pong74ls/ComputerSpaceDesign/PCB Pictures/Sync Star Board - Solder Side.JPG

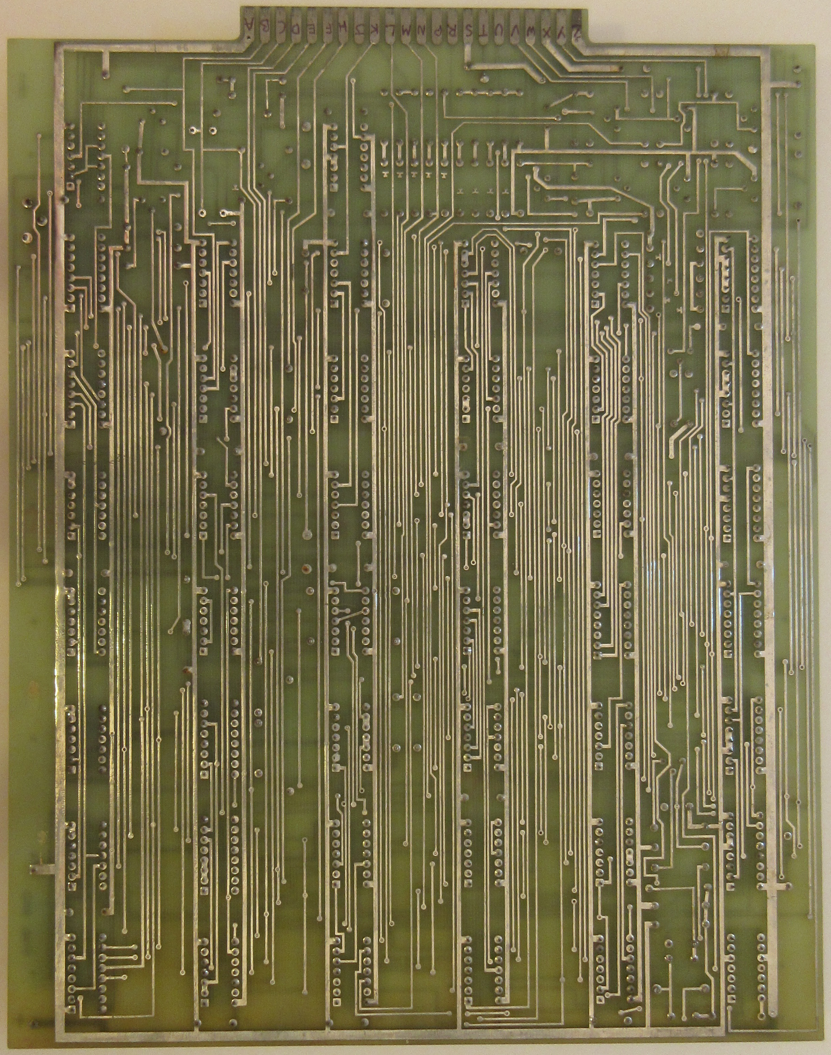
PCB Pictures/Sync Star Board - Solder Side.JPG
