pong74ls/ComputerSpaceDesign/Gerber/Computer Space - Memory Board - CADCAM Mechanical 1.TXT

G04 PROTEUS RS274X GERBER FILE*
%FSLAX24Y24*%
%MOIN*%
%ADD23C,0.0010*%
%ADD17C,0.0100*%
G54D23*
X+3750Y+0D02*
X+103750Y+0D01*
X+103750Y+81250D01*
X+3750Y+81250D01*
X+3750Y+60300D01*
X+0Y+60300D01*
X+0Y+25500D01*
X+3750Y+25500D01*
X+3750Y+0D01*
G54D17*
X+150Y+60300D02*
X+150Y+25500D01*
M00*
