pong74ls/ComputerSpaceDesign/Gerber/Computer Space - Motion Board - CADCAM Mechanical 1.TXT

G04 PROTEUS RS274X GERBER FILE*
%FSLAX24Y24*%
%MOIN*%
%ADD24C,0.0010*%
G54D24*
X+0Y+0D02*
X+100000Y+0D01*
X+100000Y+16750D01*
X+103750Y+16750D01*
X+103750Y+51500D01*
X+100000Y+51500D01*
X+100000Y+80500D01*
X+0Y+80500D01*
X+0Y+0D01*
M00*
