pong74ls/ComputerSpaceDesign/Gerber/Computer Space - Sync Star Board Model 1 - CADCAM Mechanical 1.TXT

G04 PROTEUS RS274X GERBER FILE*
%FSLAX24Y24*%
%MOIN*%
%ADD25C,0.0010*%
%ADD29C,0.0060*%
G54D25*
X+103400Y+23000D02*
X+99750Y+23000D01*
X+99750Y+0D01*
X+0Y+0D01*
X+0Y+80750D01*
X+99750Y+80750D01*
X+99750Y+57750D01*
X+103400Y+57750D01*
X+103400Y+23000D01*
G54D29*
X+103300Y+57750D02*
X+103300Y+23000D01*
M00*
