pong74ls/ComputerSpaceDesign/Datasheets/GE Television Modifications.jpg

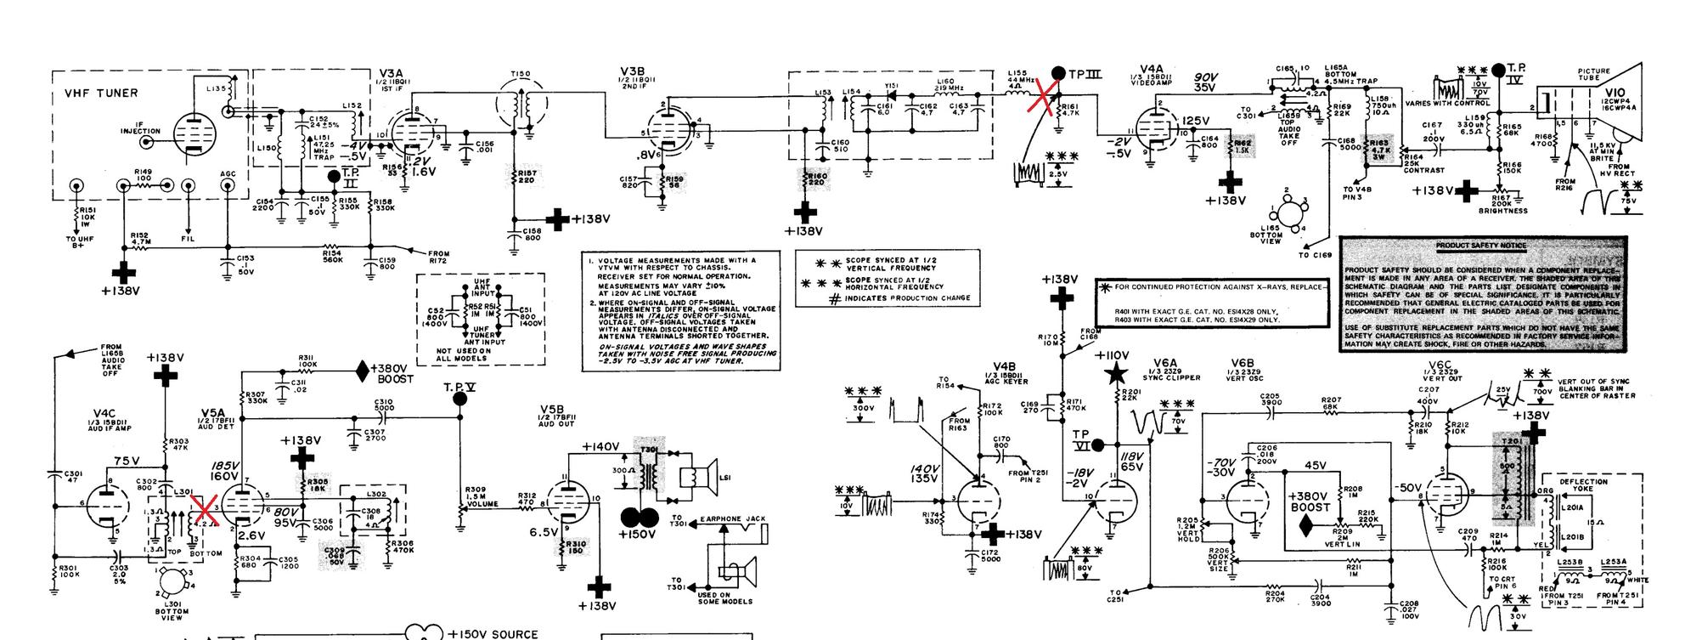
Datasheets/GE Television Modifications.jpg
