pong74ls/ComputerSpaceDesign/Datasheets/TO-105 transistor case pinout.png

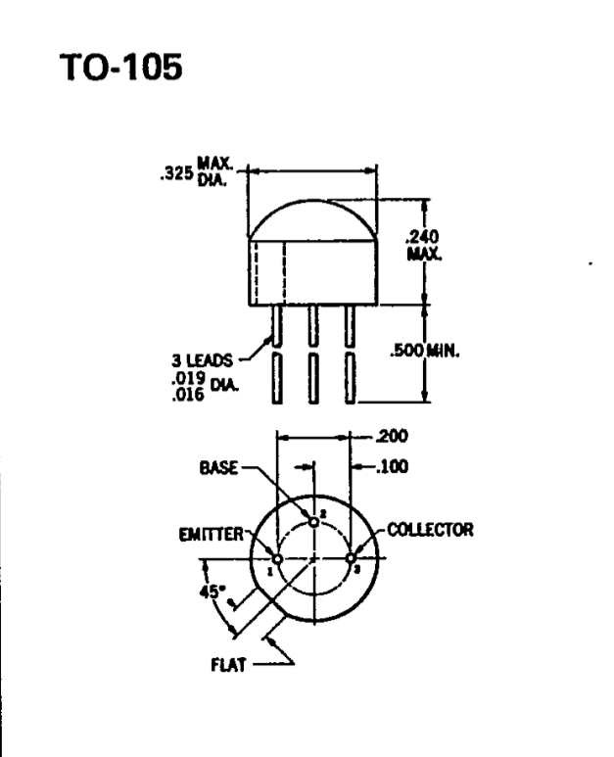
Datasheets/TO-105 transistor case pinout.png
