pong74ls/ComputerSpaceDesign/PCB Pictures/Sync Star Board - Video Mixer Detail.JPG

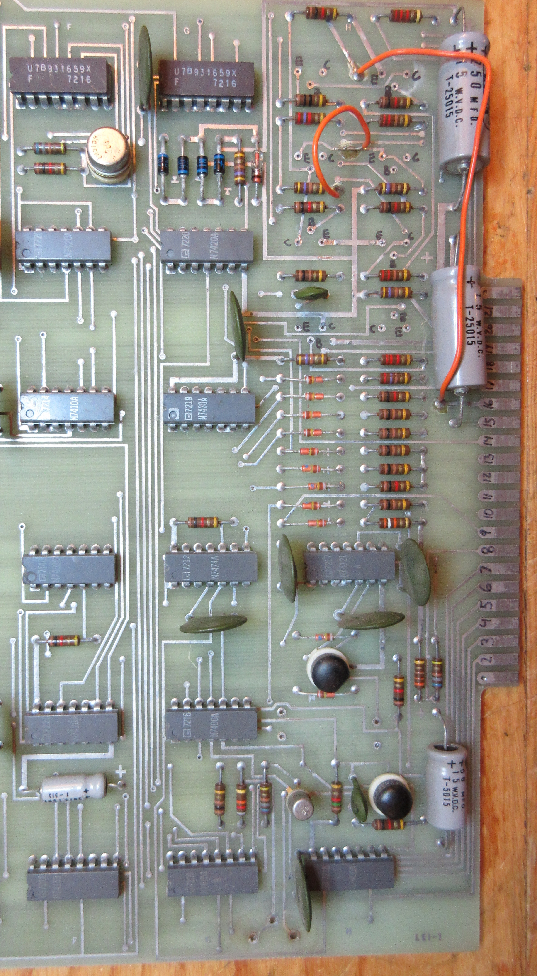
PCB Pictures/Sync Star Board - Video Mixer Detail.JPG
