pong74ls/ComputerSpaceDesign/PCB Scan/Memory Board Bottom B&W.bmp

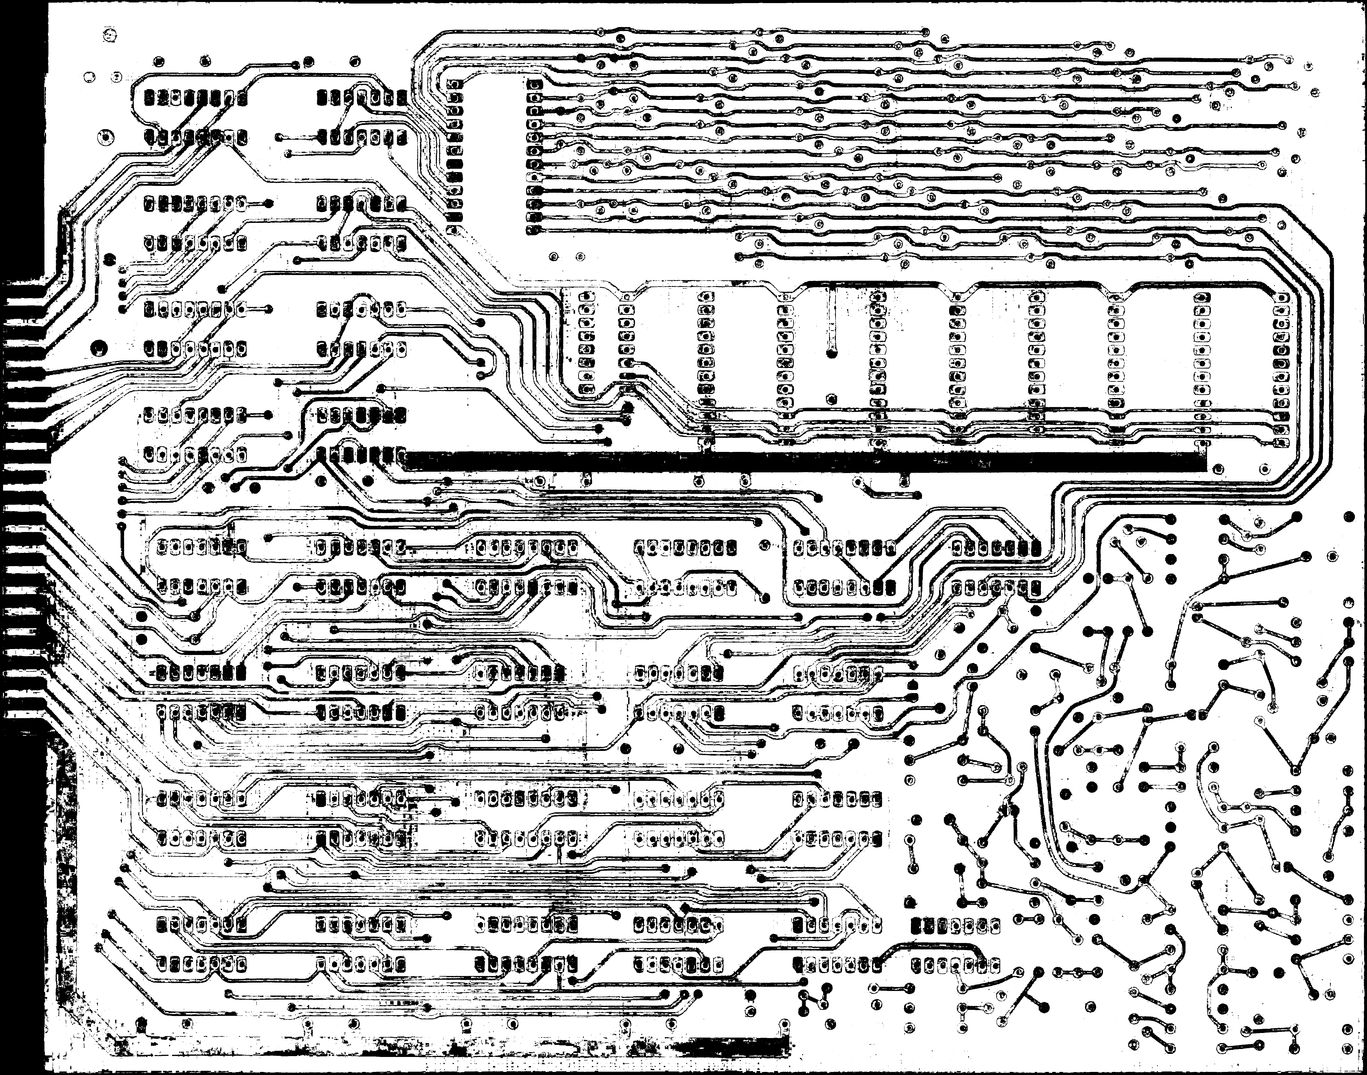
PCB Scan/Memory Board Bottom B&W.bmp
