pong74ls/ComputerSpaceDesign/PCB Scan/Memory Board Top B&W.bmp

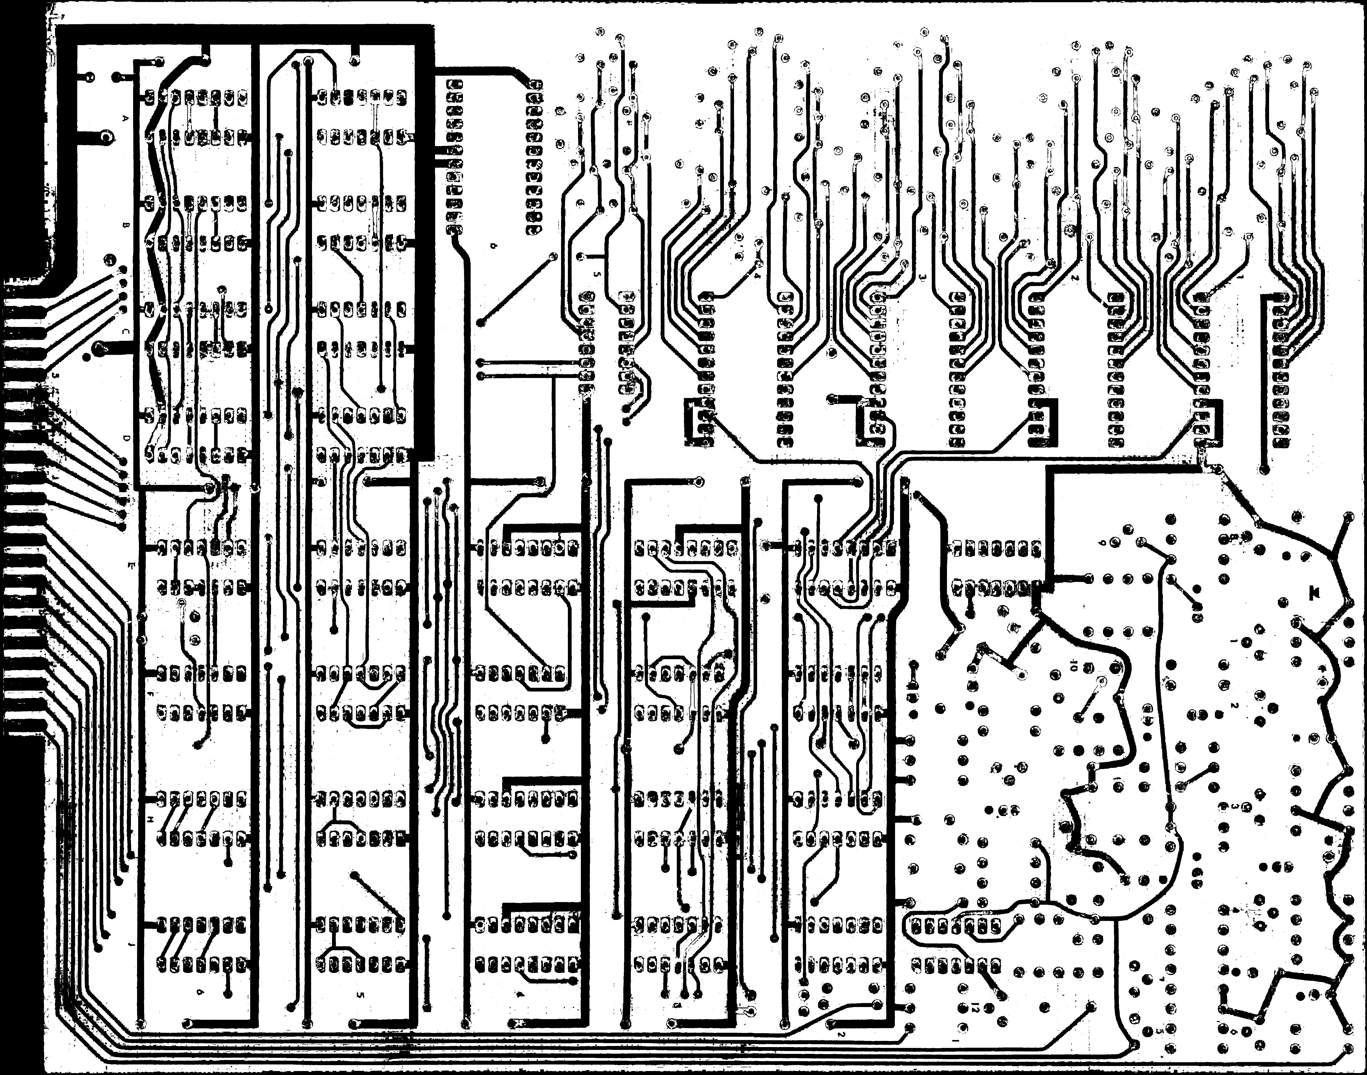
PCB Scan/Memory Board Top B&W.bmp
