pong74ls/ComputerSpaceDesign/PCB Scan/Motion Board Bottom B&W.bmp

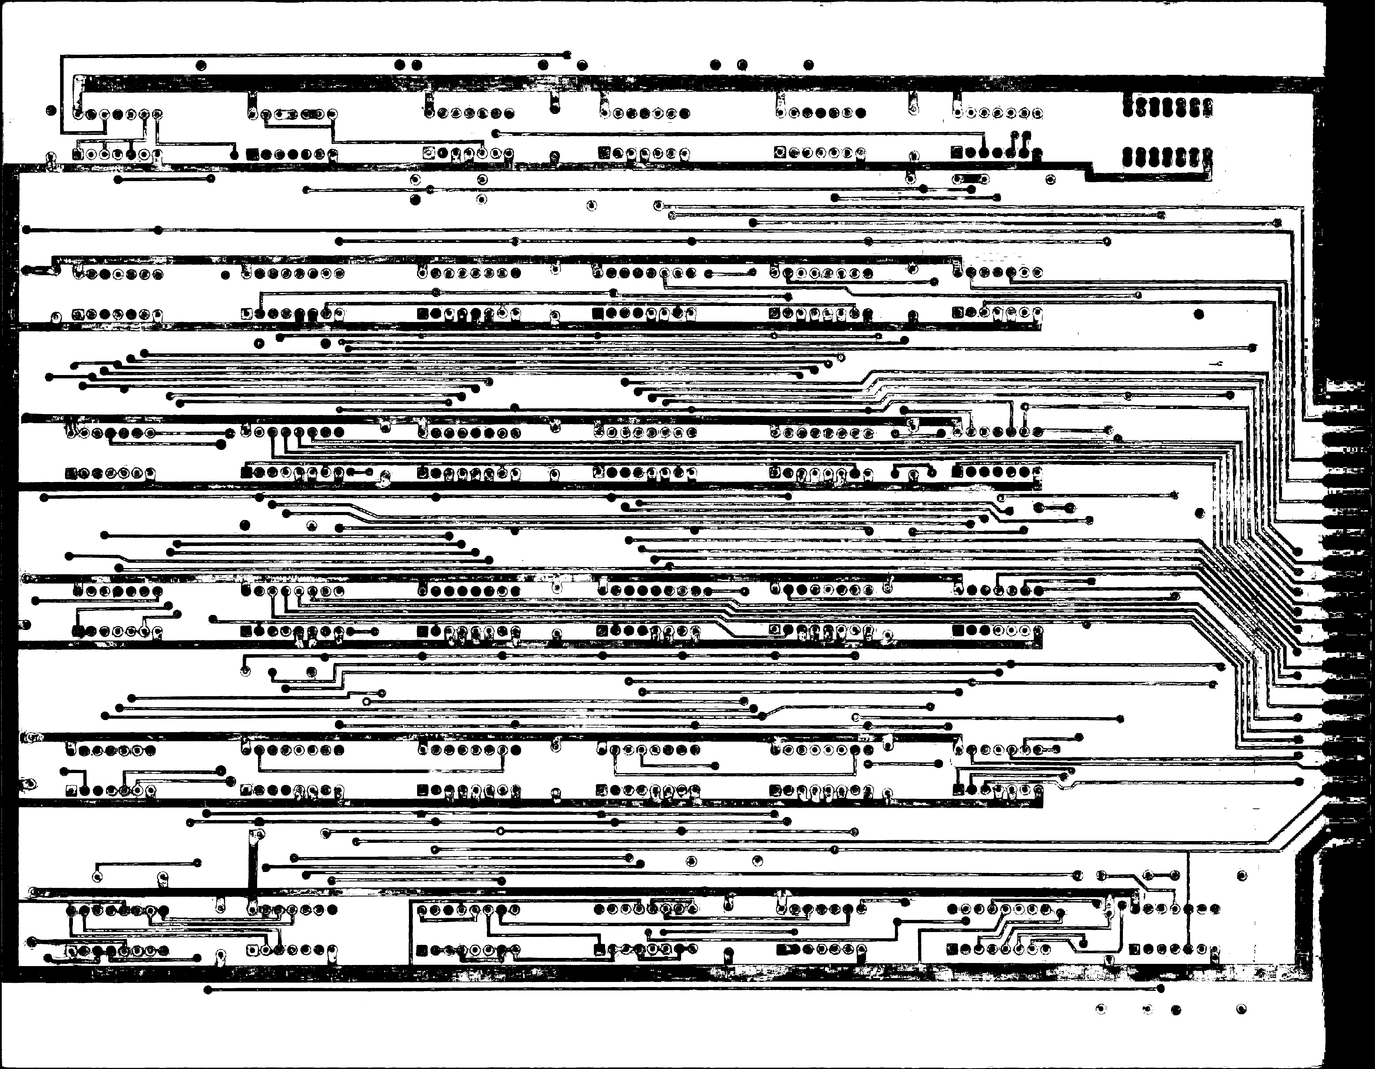
PCB Scan/Motion Board Bottom B&W.bmp
