pong74ls/ComputerSpaceDesign/PCB Scan/Motion Board Top B&W.bmp

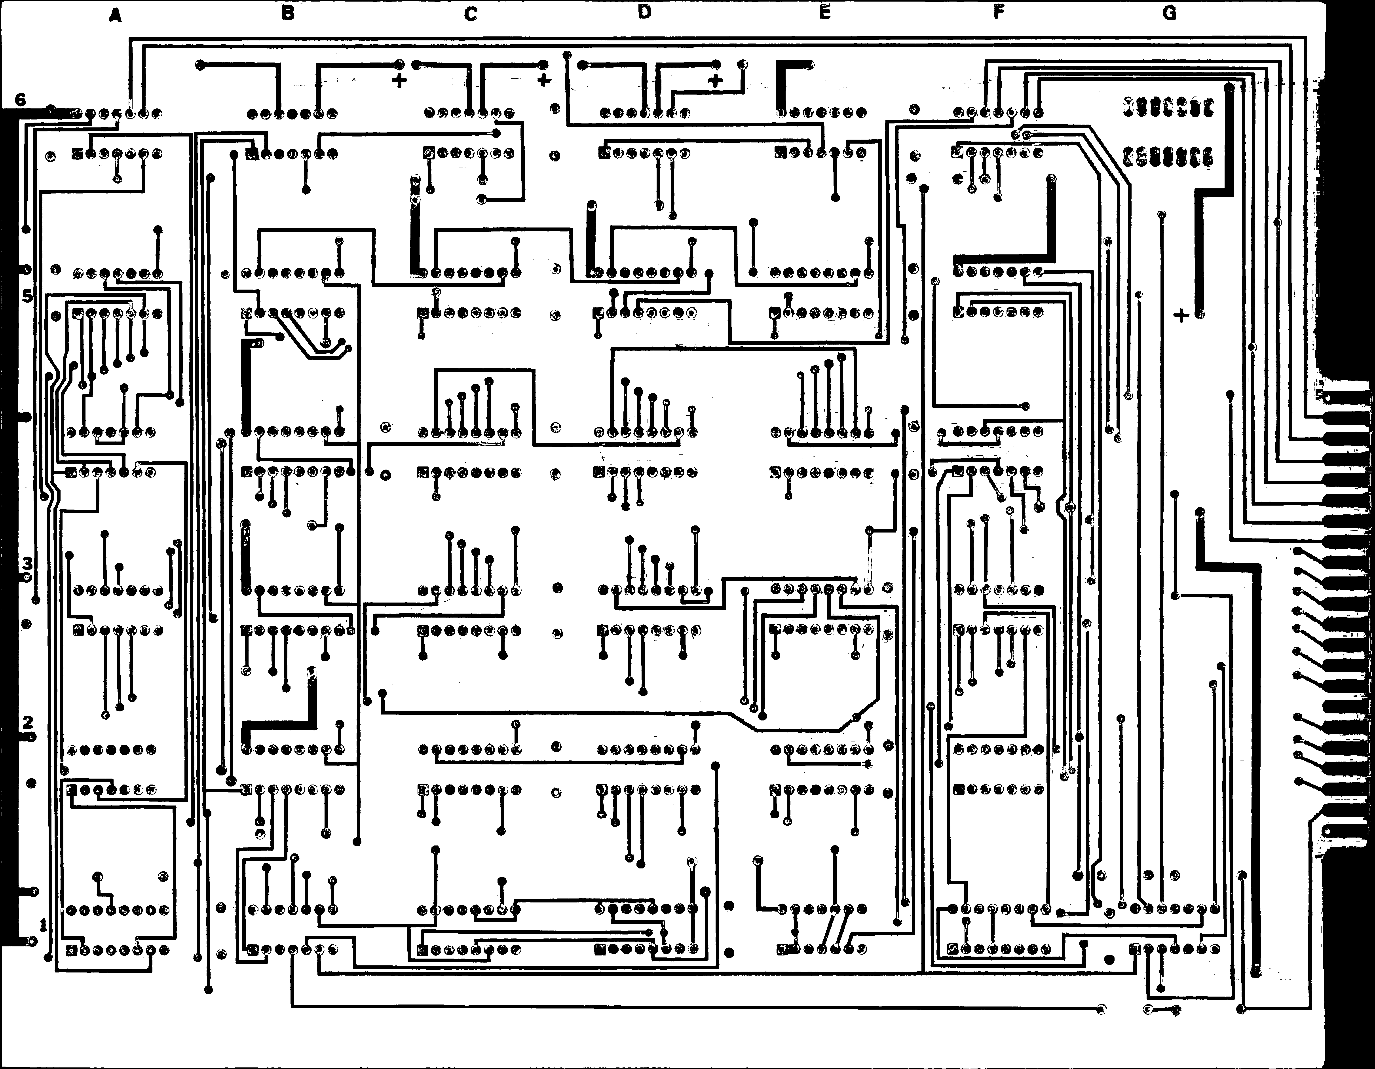
PCB Scan/Motion Board Top B&W.bmp
