pong74ls/ComputerSpaceDesign/PCB Scan/Sync Board Bottom B&W.bmp

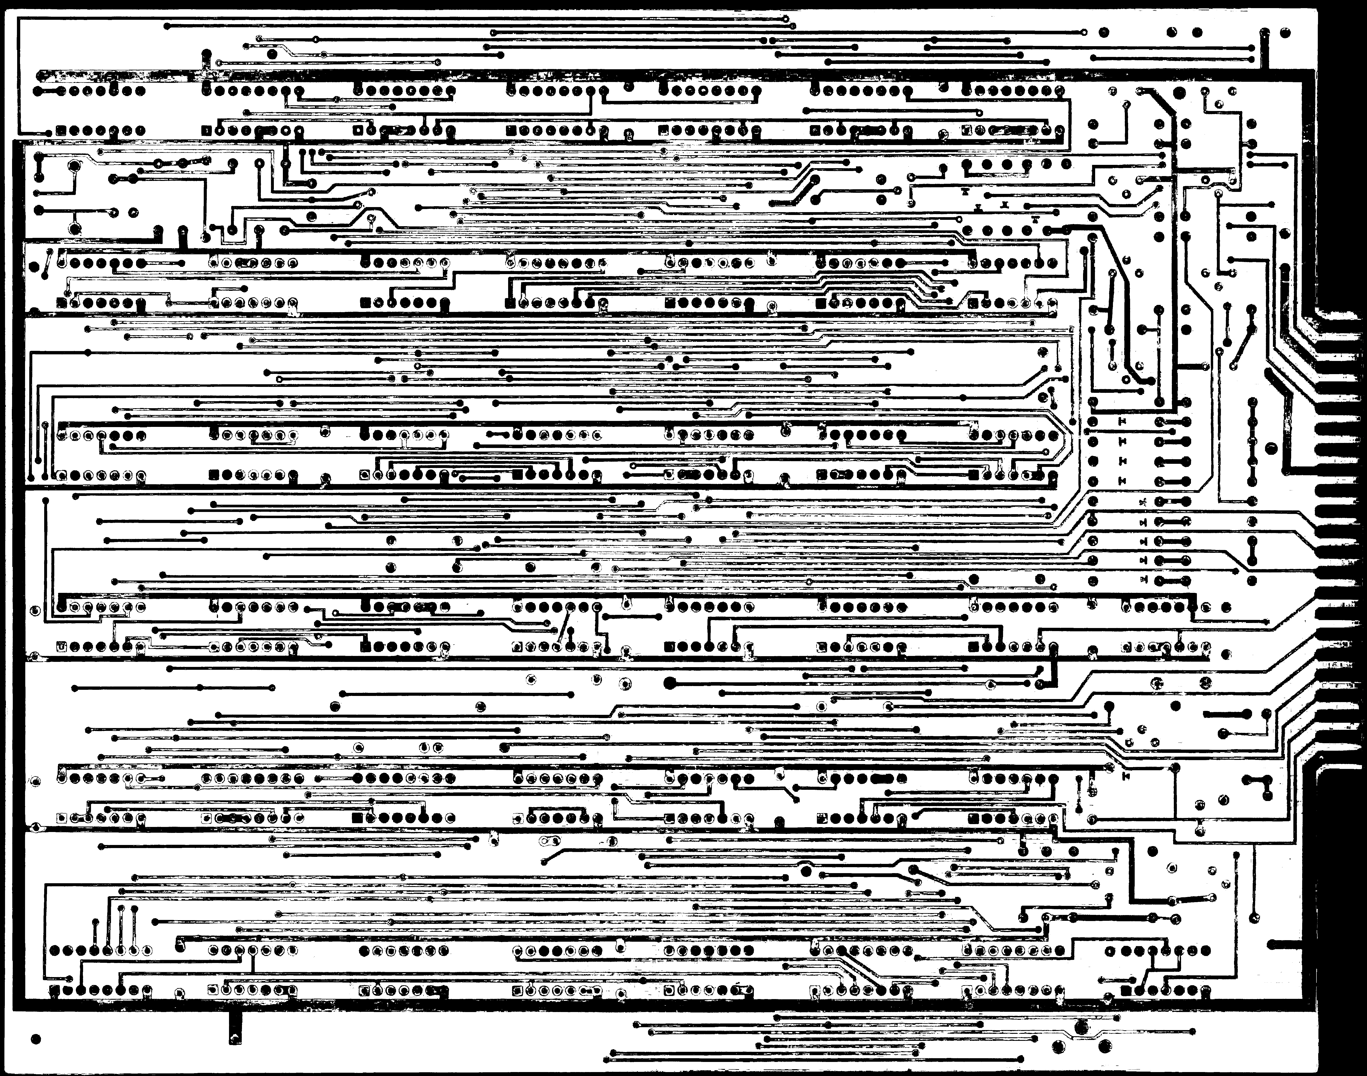
PCB Scan/Sync Board Bottom B&W.bmp
