pong74ls/ComputerSpaceDesign/PCB Scan/Sync Board Top B&W.bmp

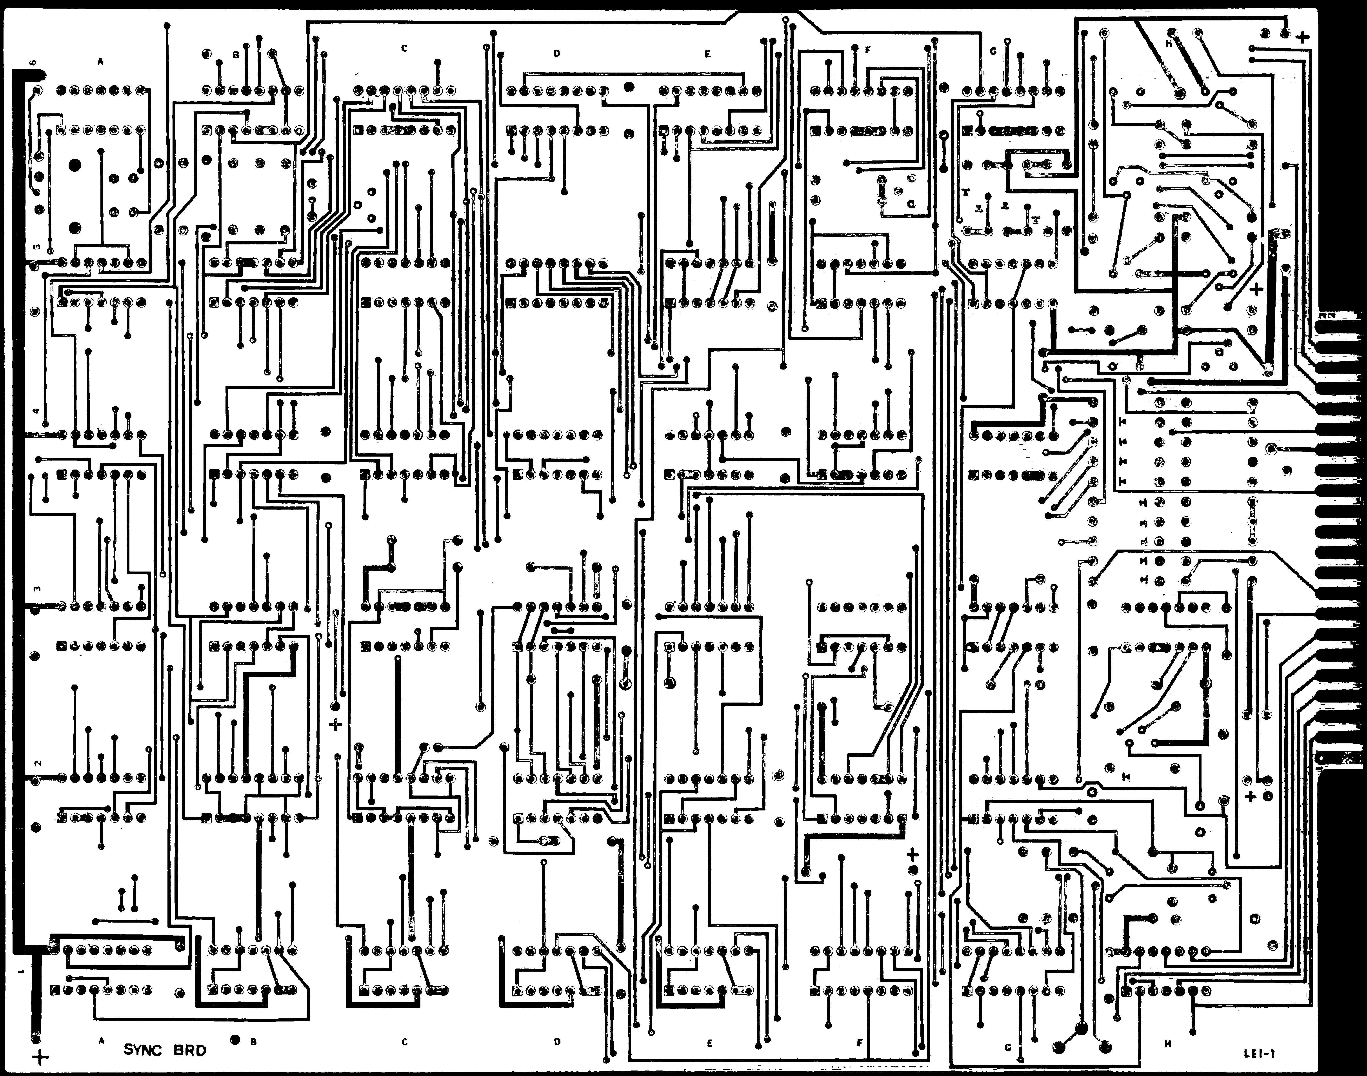
PCB Scan/Sync Board Top B&W.bmp
