pong74ls/ComputerSpaceDesign/PCB Pictures/Memory Board - Component Side.JPG

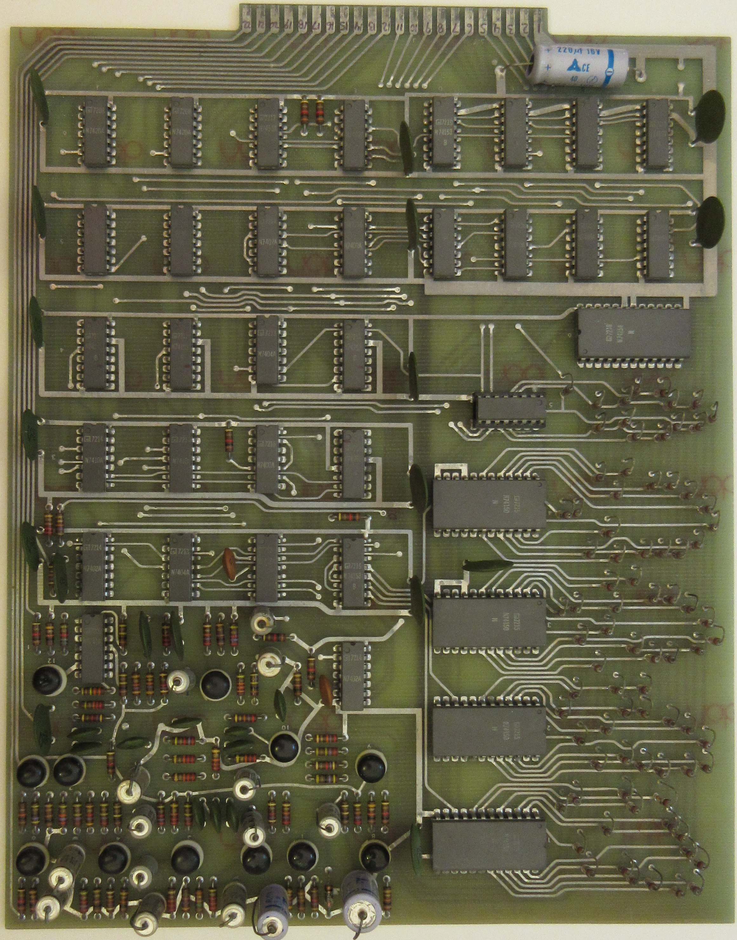
PCB Pictures/Memory Board - Component Side.JPG
