pong74ls/ComputerSpaceDesign/PCB Pictures/Motion Board - Component Side.JPG

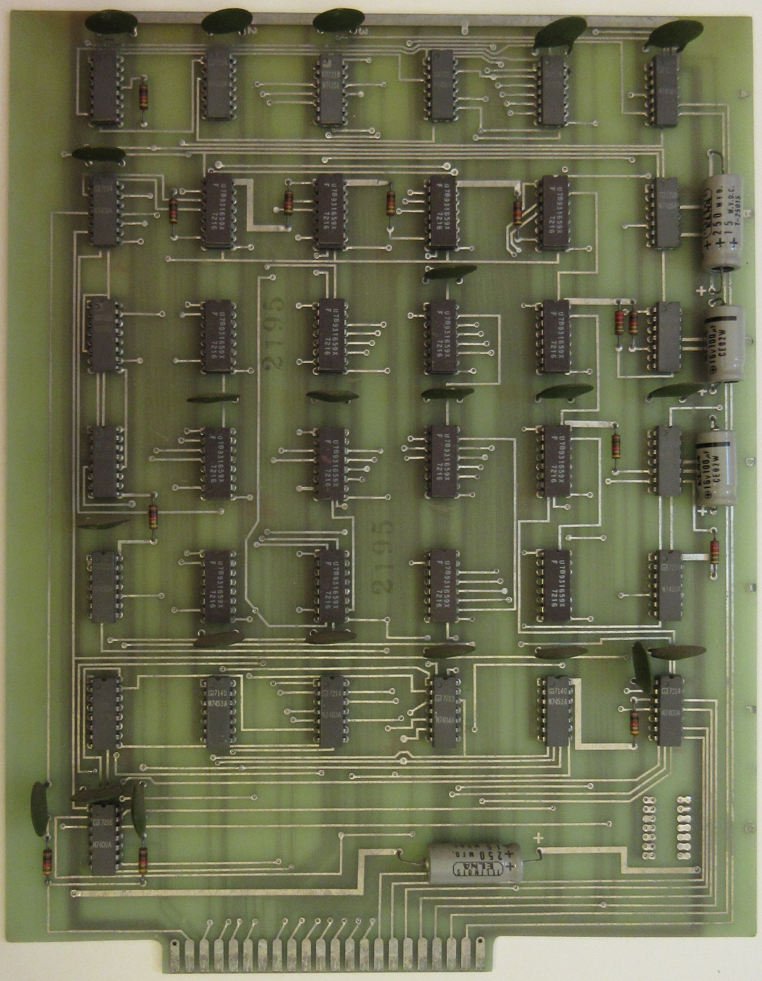
PCB Pictures/Motion Board - Component Side.JPG
