pong74ls/ComputerSpaceDesign/PCB Pictures/Sync Star Board - Component Side.JPG

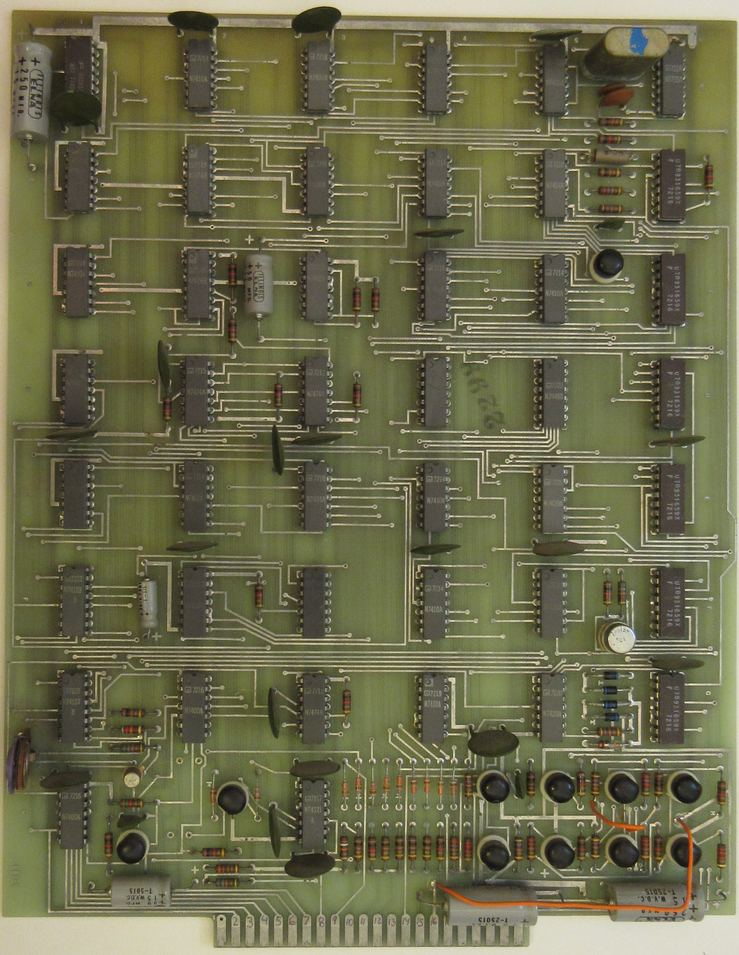
PCB Pictures/Sync Star Board - Component Side.JPG
