pong74ls/ComputerSpaceDesign/Gerber/Computer Space - Memory Board - CADCAM Bottom Solder Resist.TXT

G04 PROTEUS RS274X GERBER FILE*
%FSLAX24Y24*%
%MOIN*%
%ADD26R,0.0700X0.0700*%
%ADD20C,0.0700*%
%ADD27R,0.3700X0.1200*%
%ADD28C,0.1300*%
%ADD29C,0.0900*%
%ADD71C,0.1000*%
%ADD72C,0.1800*%
%ADD23C,0.0010*%
G54D26*
X+40900Y+63900D03*
G54D20*
X+40900Y+64900D03*
X+40900Y+65900D03*
X+40900Y+66900D03*
X+40900Y+67900D03*
X+40900Y+68900D03*
X+40900Y+69900D03*
X+40900Y+70900D03*
X+40900Y+71900D03*
X+40900Y+72900D03*
X+40900Y+73900D03*
X+40900Y+74900D03*
X+34900Y+74900D03*
X+34900Y+73900D03*
X+34900Y+72900D03*
X+34900Y+71900D03*
X+34900Y+70900D03*
X+34900Y+69900D03*
X+34900Y+68900D03*
X+34900Y+67900D03*
X+34900Y+66900D03*
X+34900Y+65900D03*
X+34900Y+64900D03*
X+34900Y+63900D03*
G54D26*
X+44900Y+58800D03*
G54D20*
X+44900Y+57800D03*
X+44900Y+56800D03*
X+44900Y+55800D03*
X+44900Y+54800D03*
X+44900Y+53800D03*
X+44900Y+52800D03*
X+44900Y+51800D03*
X+47900Y+51800D03*
X+47900Y+52800D03*
X+47900Y+53800D03*
X+47900Y+54800D03*
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
