pong74ls/ComputerSpaceDesign/Gerber/Computer Space - Motion Board - CADCAM Bottom Solder Resist.TXT

G04 PROTEUS RS274X GERBER FILE*
%FSLAX24Y24*%
%MOIN*%
%ADD29R,0.0700X0.0700*%
%ADD23C,0.0700*%
%ADD72R,0.3700X0.1200*%
%ADD20C,0.0800*%
%ADD21C,0.1000*%
%ADD73C,0.1300*%
%ADD30C,0.1800*%
%ADD31C,0.0900*%
%ADD24C,0.0010*%
G54D29*
X+5350Y+8750D03*
G54D23*
X+6350Y+8750D03*
X+7350Y+8750D03*
X+8350Y+8750D03*
X+9350Y+8750D03*
X+10350Y+8750D03*
X+11350Y+8750D03*
X+12350Y+8750D03*
X+12350Y+11750D03*
X+11350Y+11750D03*
X+10350Y+11750D03*
X+9350Y+11750D03*
X+8350Y+11750D03*
X+7350Y+11750D03*
X+6350Y+11750D03*
X+5350Y+11750D03*
G54D72*
X+101800Y+17750D03*
X+101800Y+19310D03*
X+101800Y+20870D03*
X+101800Y+22430D03*
X+101800Y+23990D03*
X+101800Y+25550D03*
X+101800Y+27110D03*
X+101800Y+28670D03*
X+101800Y+30230D03*
X+101800Y+31790D03*
X+101800Y+33350D03*
X+101800Y+34910D03*
X+101800Y+36470D03*
X+101800Y+38030D03*
X+101800Y+39590D03*
X+101800Y+41150D03*
X+101800Y+42710D03*
X+101800Y+44270D03*
X+101800Y+45830D03*
X+101800Y+47390D03*
X+101800Y+48950D03*
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
