pong74ls/ComputerSpaceDesign/Gerber/Computer Space - Sync Star Board Model 1 - CADCAM Bottom Solder Resist.TXT

G04 PROTEUS RS274X GERBER FILE*
%FSLAX24Y24*%
%MOIN*%
%ADD31R,0.3700X0.1200*%
%ADD32R,0.0700X0.0700*%
%ADD22C,0.0700*%
%ADD23C,0.1500*%
%ADD24C,0.1000*%
%ADD33C,0.1300*%
%ADD34C,0.0900*%
%ADD35C,0.1800*%
%ADD25C,0.0010*%
G54D31*
X+101500Y+23900D03*
X+101500Y+25460D03*
X+101500Y+27020D03*
X+101500Y+28580D03*
X+101500Y+30140D03*
X+101500Y+31700D03*
X+101500Y+33260D03*
X+101500Y+34820D03*
X+101500Y+36380D03*
X+101500Y+37940D03*
X+101500Y+39500D03*
X+101500Y+41060D03*
X+101500Y+42620D03*
X+101500Y+44180D03*
X+101500Y+45740D03*
X+101500Y+47300D03*
X+101500Y+48860D03*
X+101500Y+50420D03*
X+101500Y+51980D03*
X+101500Y+53540D03*
X+101500Y+55100D03*
X+101500Y+56660D03*
G54D32*
X+4000Y+6300D03*
G54D22*
X+5000Y+6300D03*
X+6000Y+6300D03*
X+7000Y+6300D03*
X+8000Y+6300D03*
X+9000Y+6300D03*
X+10000Y+6300D03*
X+11000Y+6300D03*
X+11000Y+9300D03*
X+10000Y+9300D03*
X+9000Y+9300D03*
X+8000Y+9300D03*
X+7000Y+9300D03*
X+6000Y+9300D03*
X+5000Y+9300D03*
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
