pong74ls/ComputerSpaceDesign/PCB Pictures/Motion Board - Solder Side.JPG

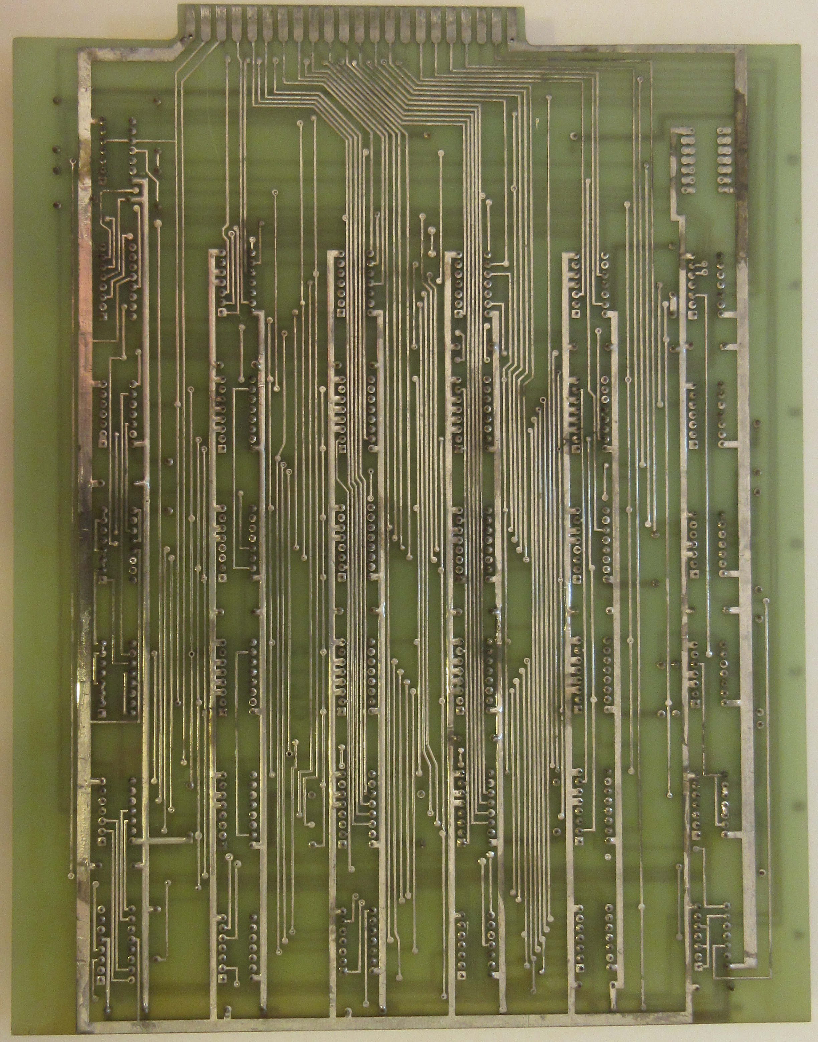
PCB Pictures/Motion Board - Solder Side.JPG
