pong74ls/ComputerSpaceDesign/PDF/Computer Space - Memory Board - Schematic.pdf

D2

D3

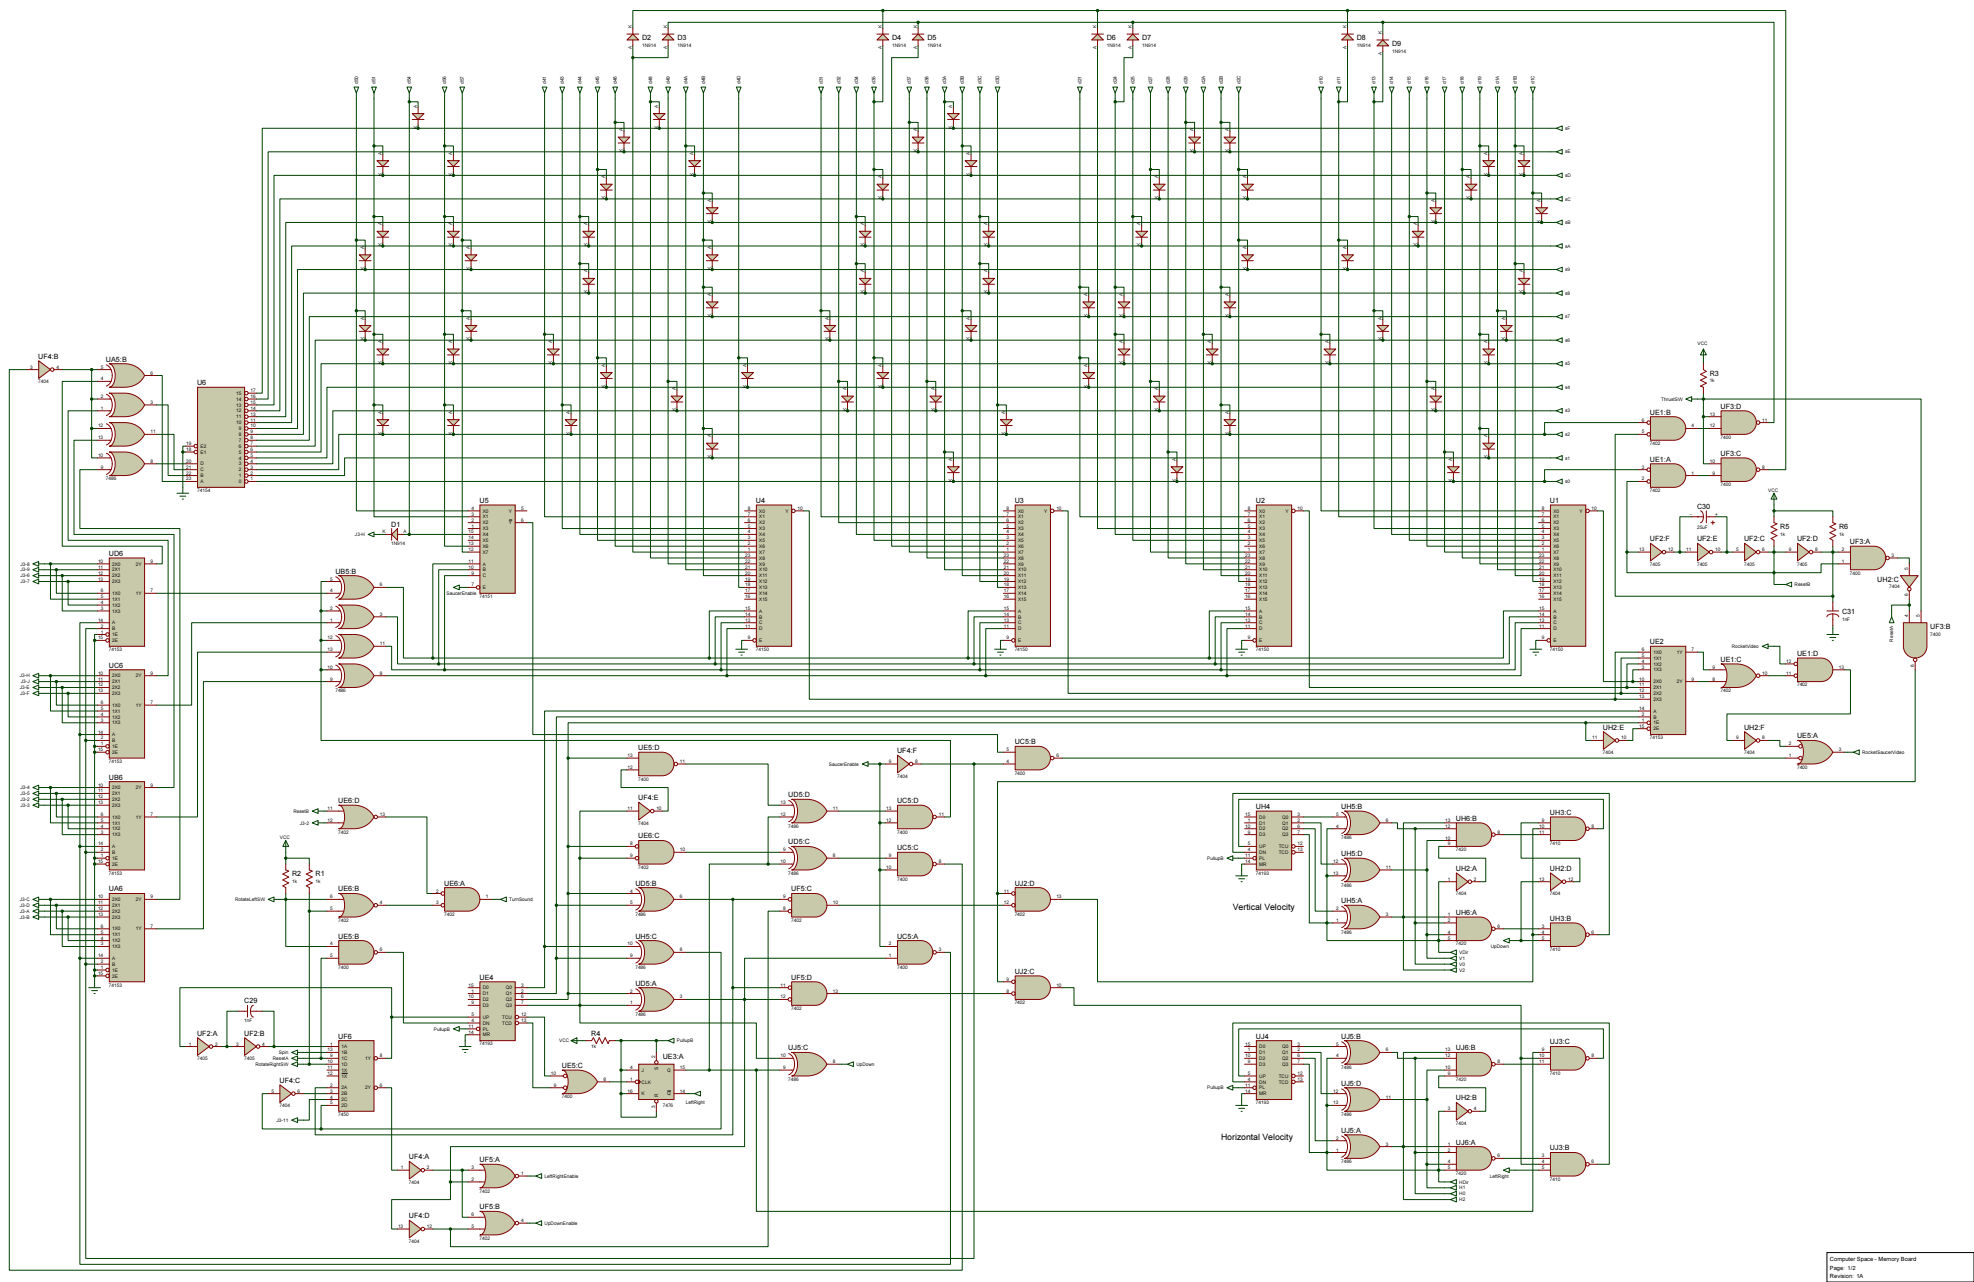
[picture p16: page 1]

Computer Space - Memory Board
Page:
Revision:

D10

R7

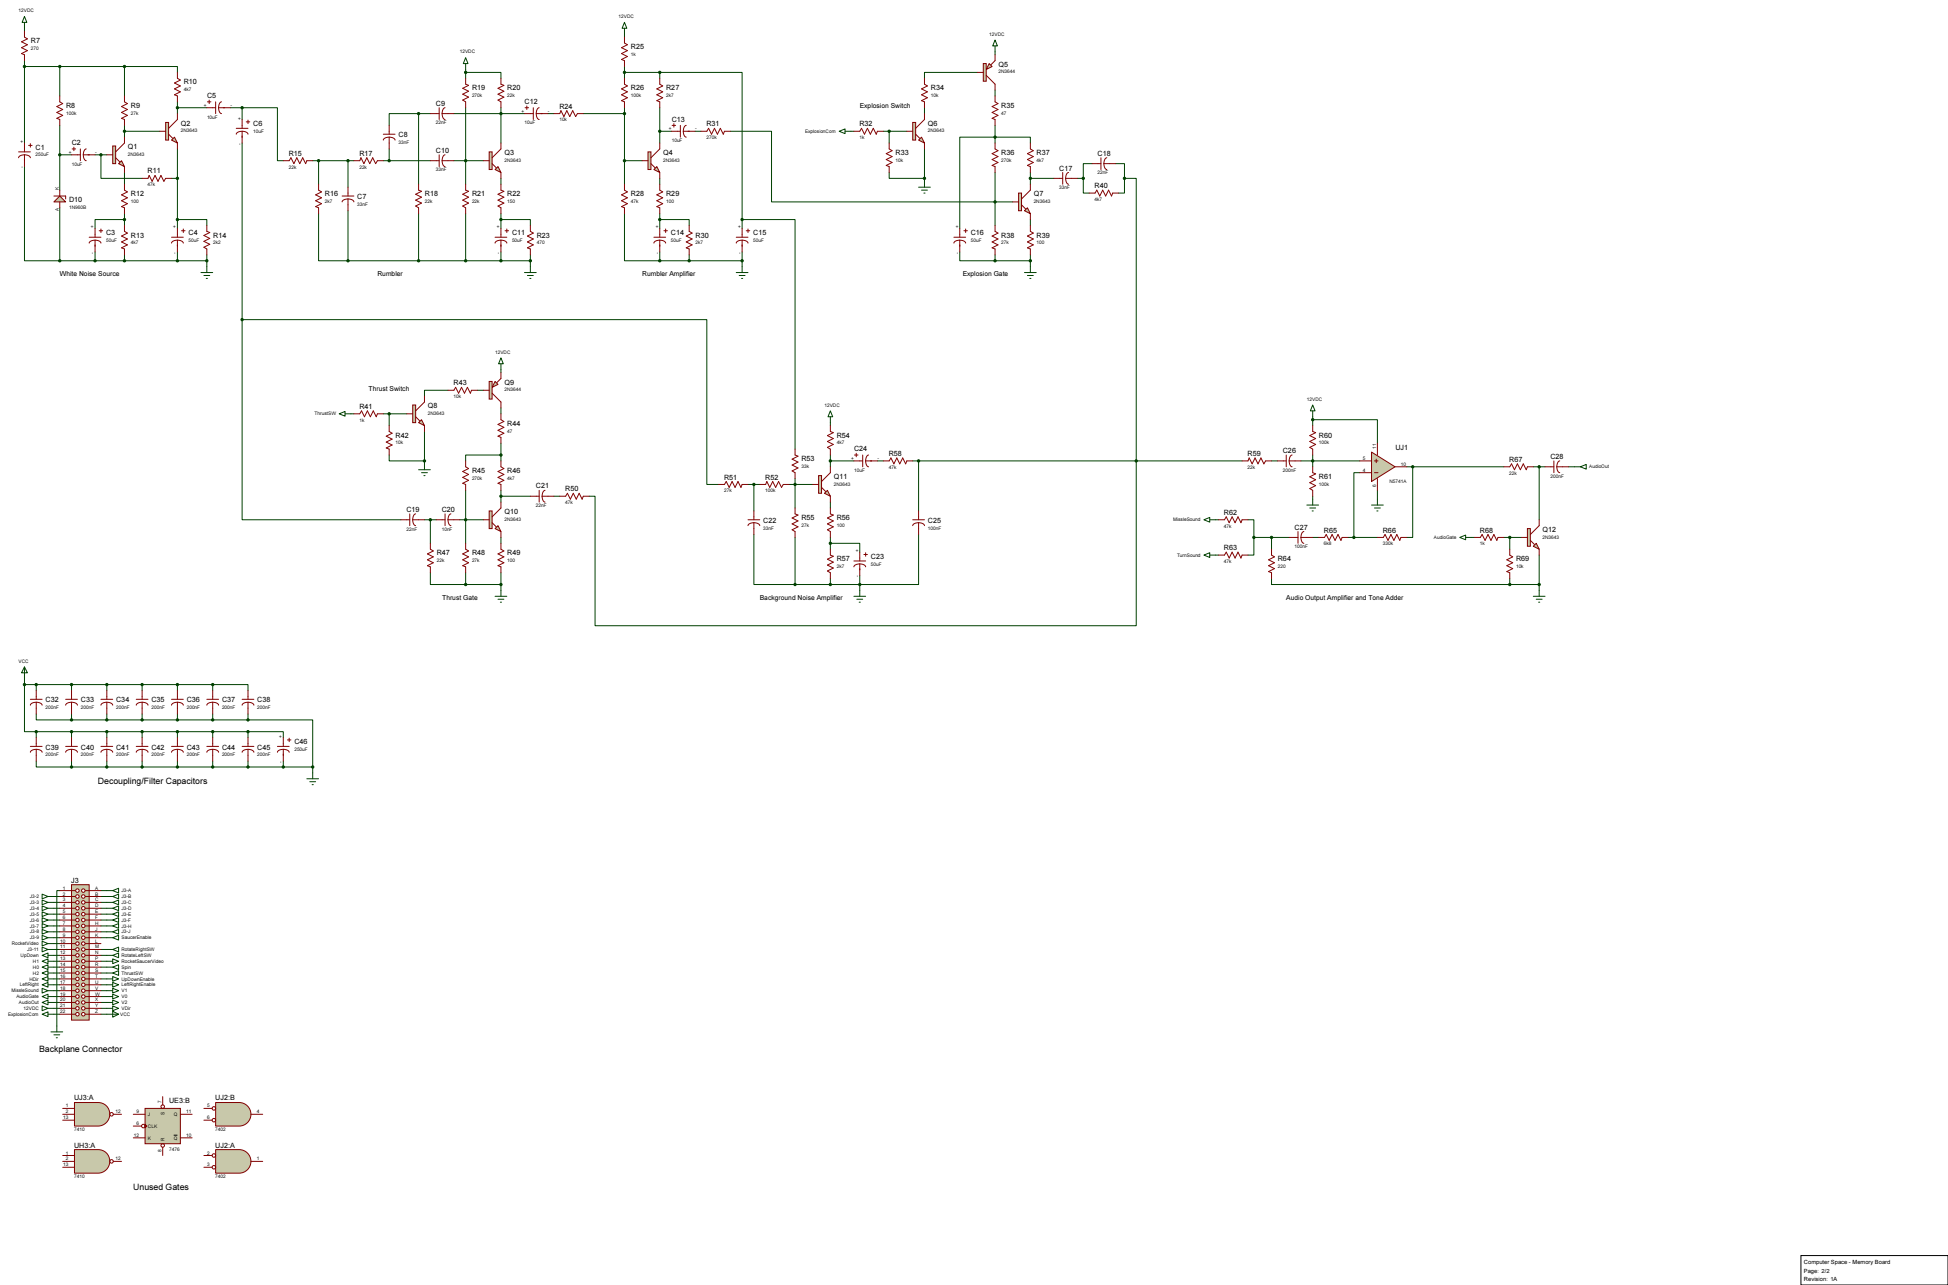
[picture p17: page 2]

Computer Space - Memory Board
Page:
Revision:
