pong74ls/ComputerSpaceDesign/PDF/Computer Space - Motion Board - Schematic.pdf

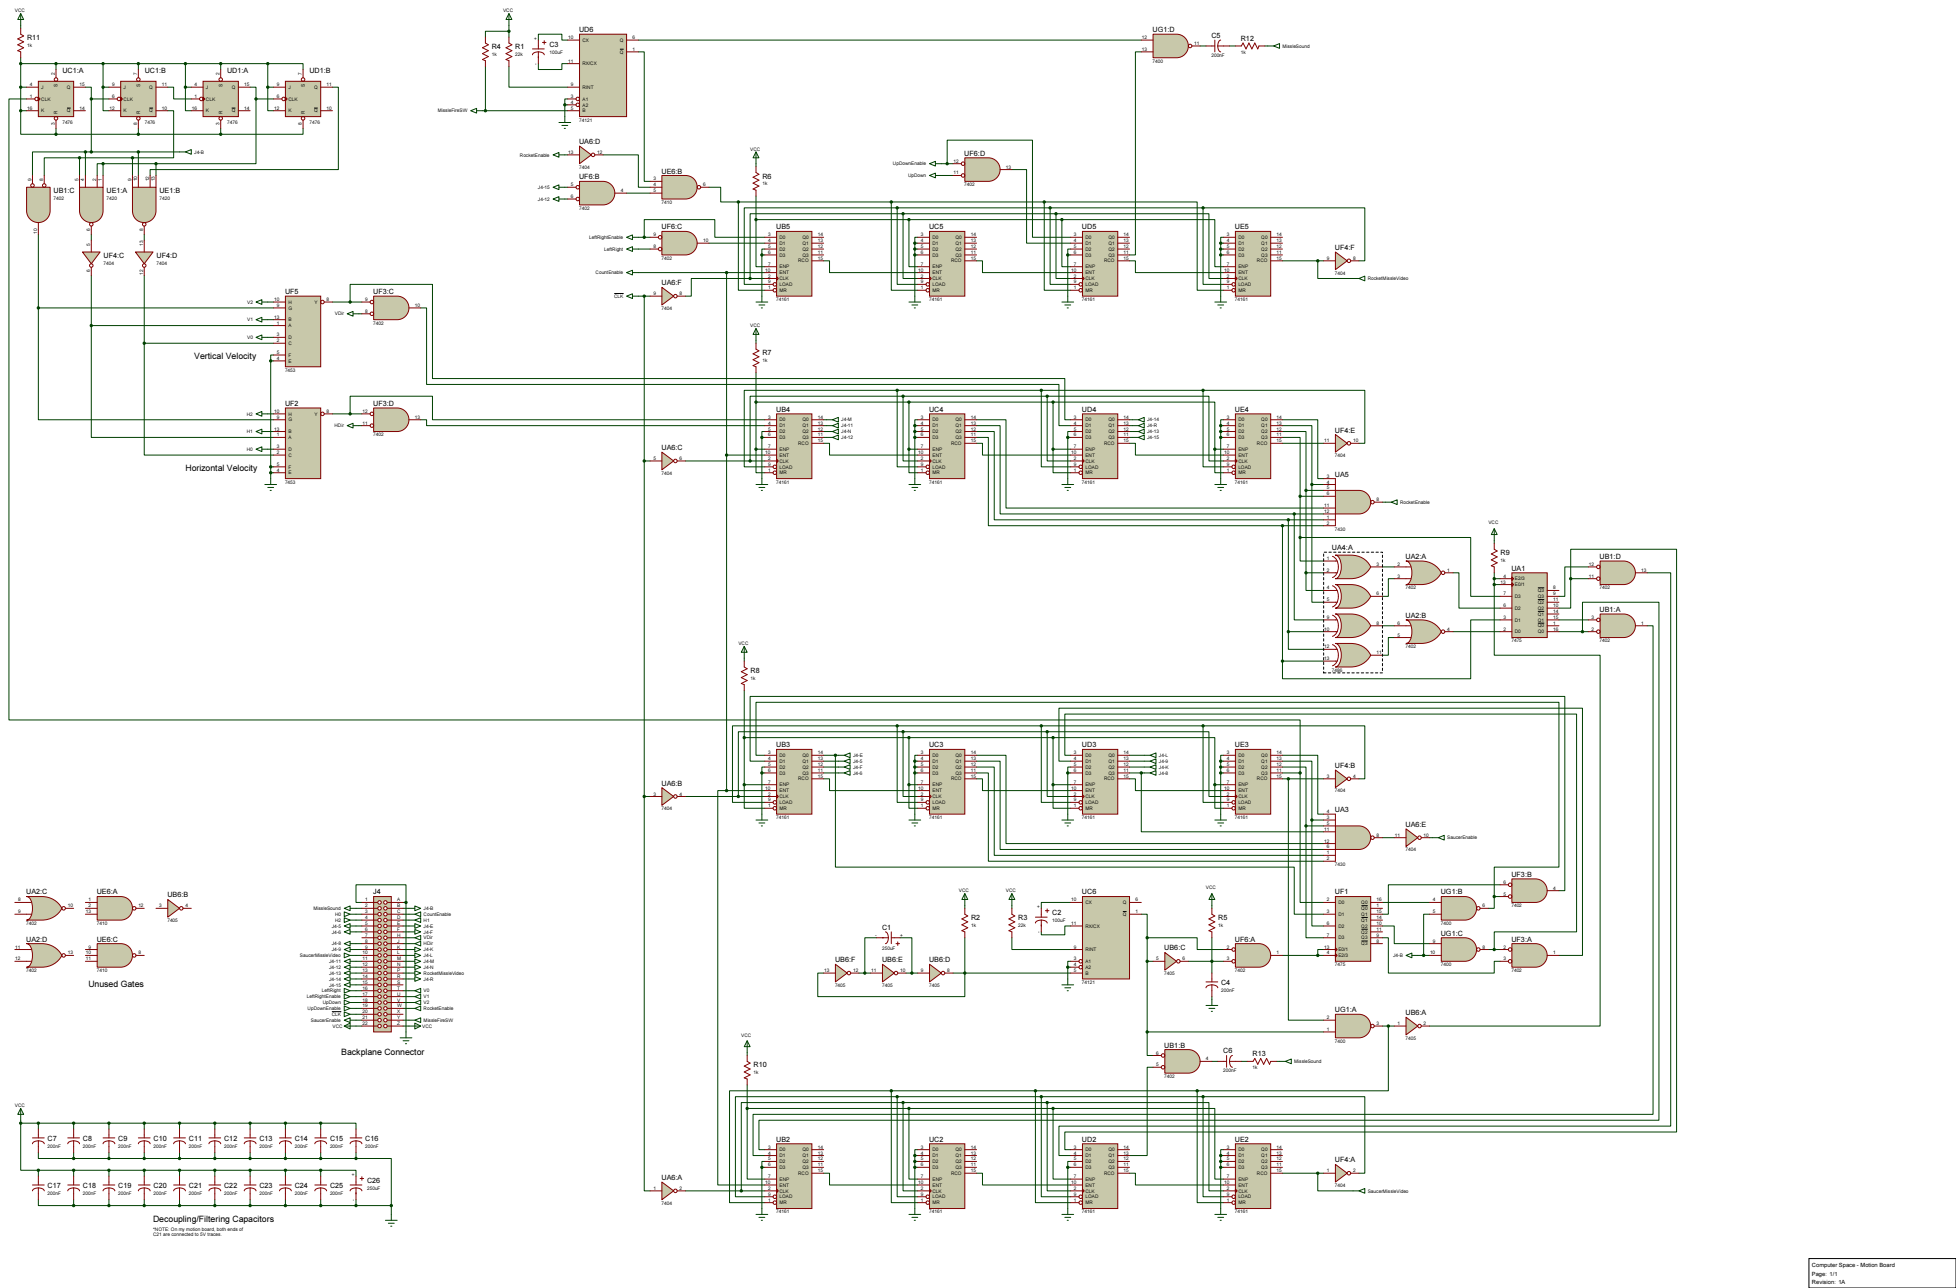
[picture p18: page 1]

*NOTE: On my motion board, both ends of
C21 are connected to 5V traces.

Computer Space - Motion Board
Page:
Revision:
