pong74ls/ComputerSpaceDesign/PDF/Computer Space - Sync Star Board Model 1 - Schematic.pdf

R3

UA6

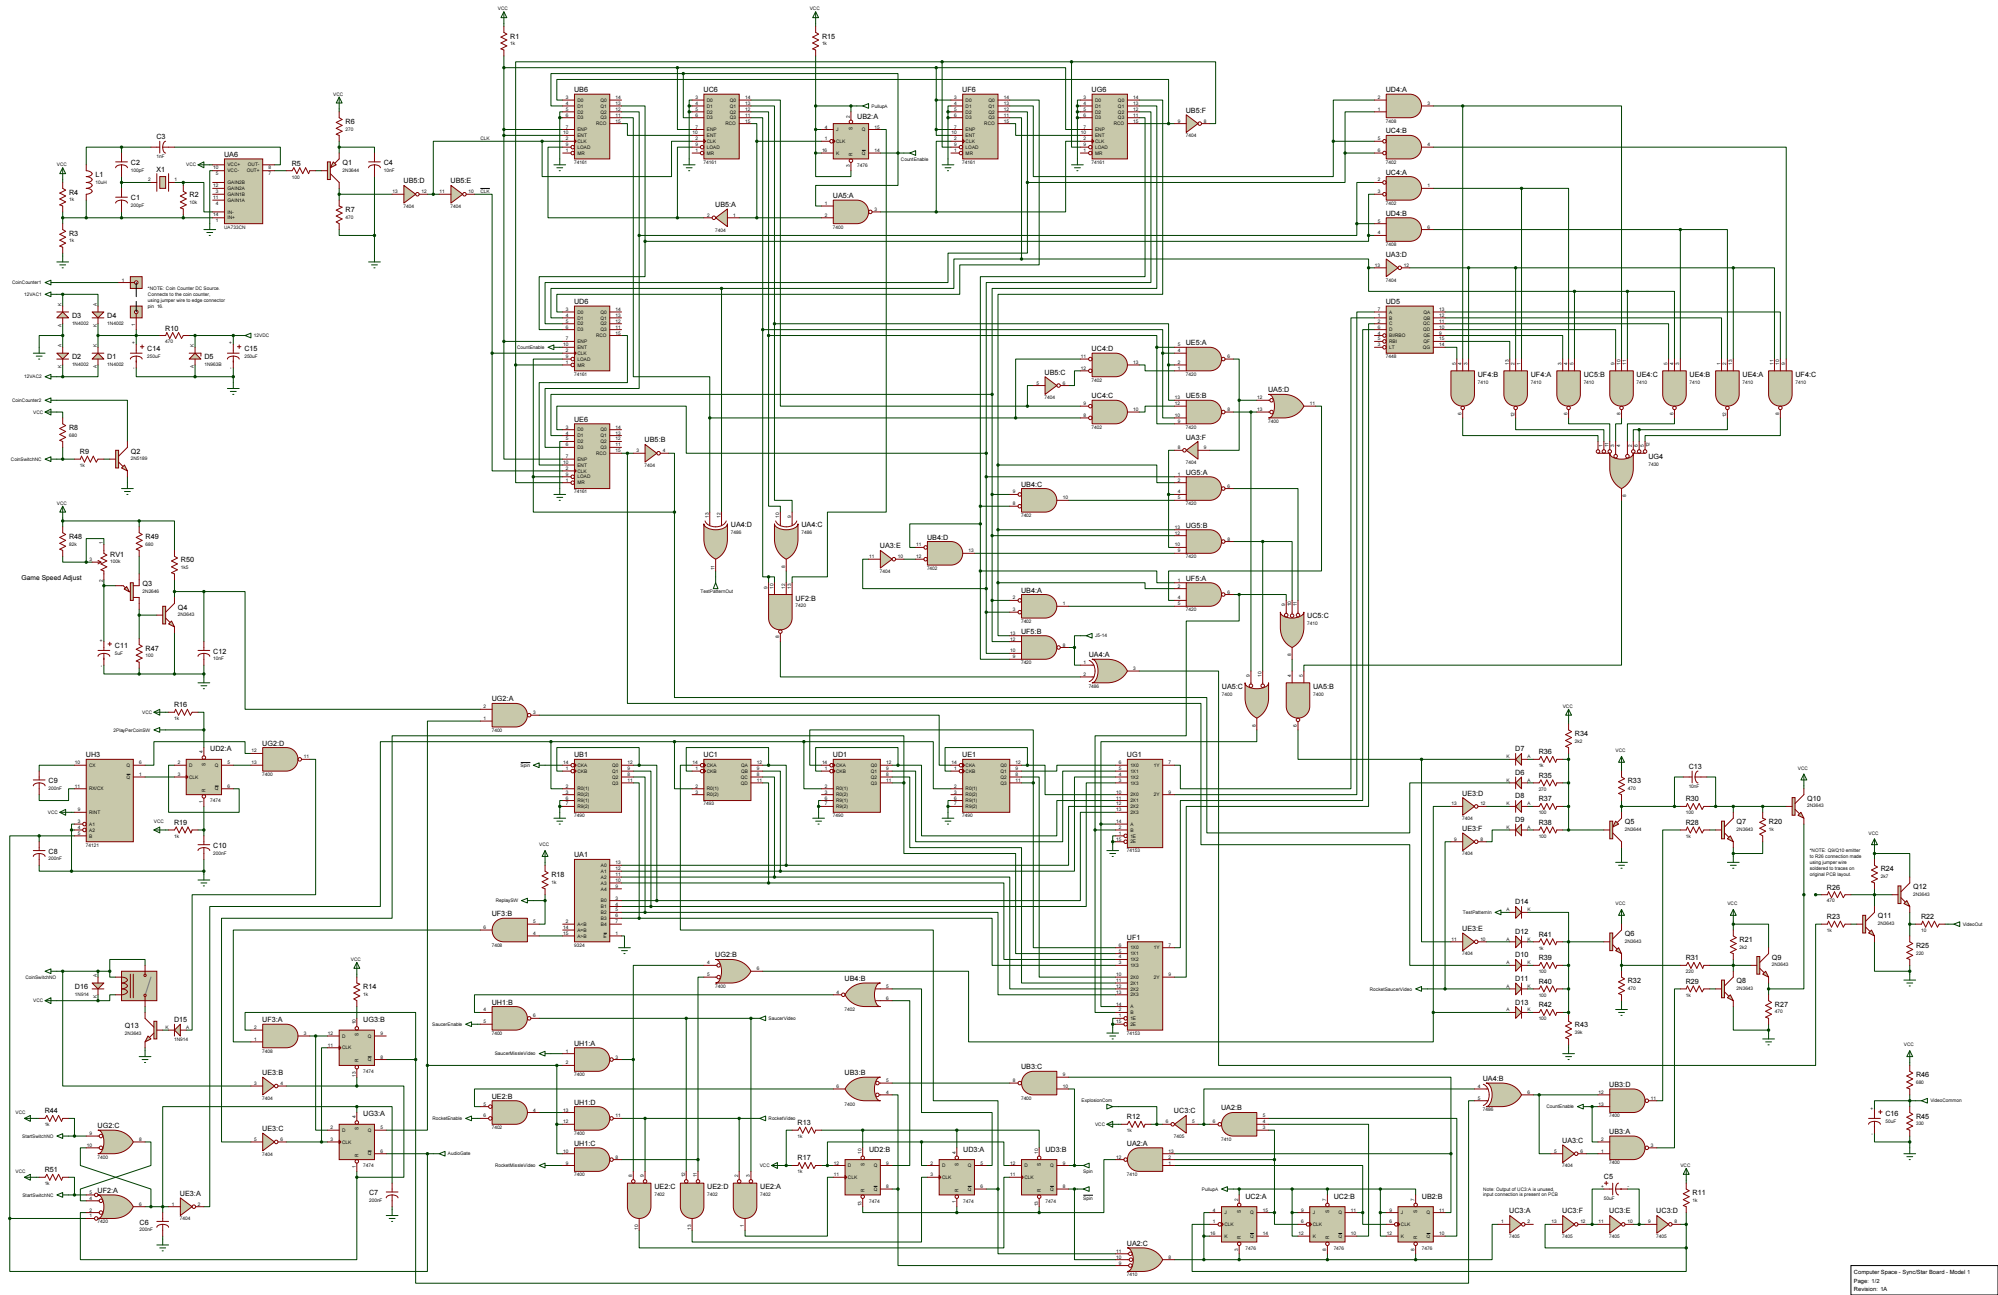
[picture p19: page 1]

*NOTE: Coin Counter DC Source.
Connects to the coin counter,
using jumper wire to edge connector
pin 16.

*NOTE: Q9/Q10 emitter
to R26 connection made
using jumper wire
soldered to traces on
original PCB layout.

Note: Output of UC3:A is unused,
input connection is present on PCB

Computer Space - Sync/Star Board - Model 1
Page:
Revision:

J5

C19

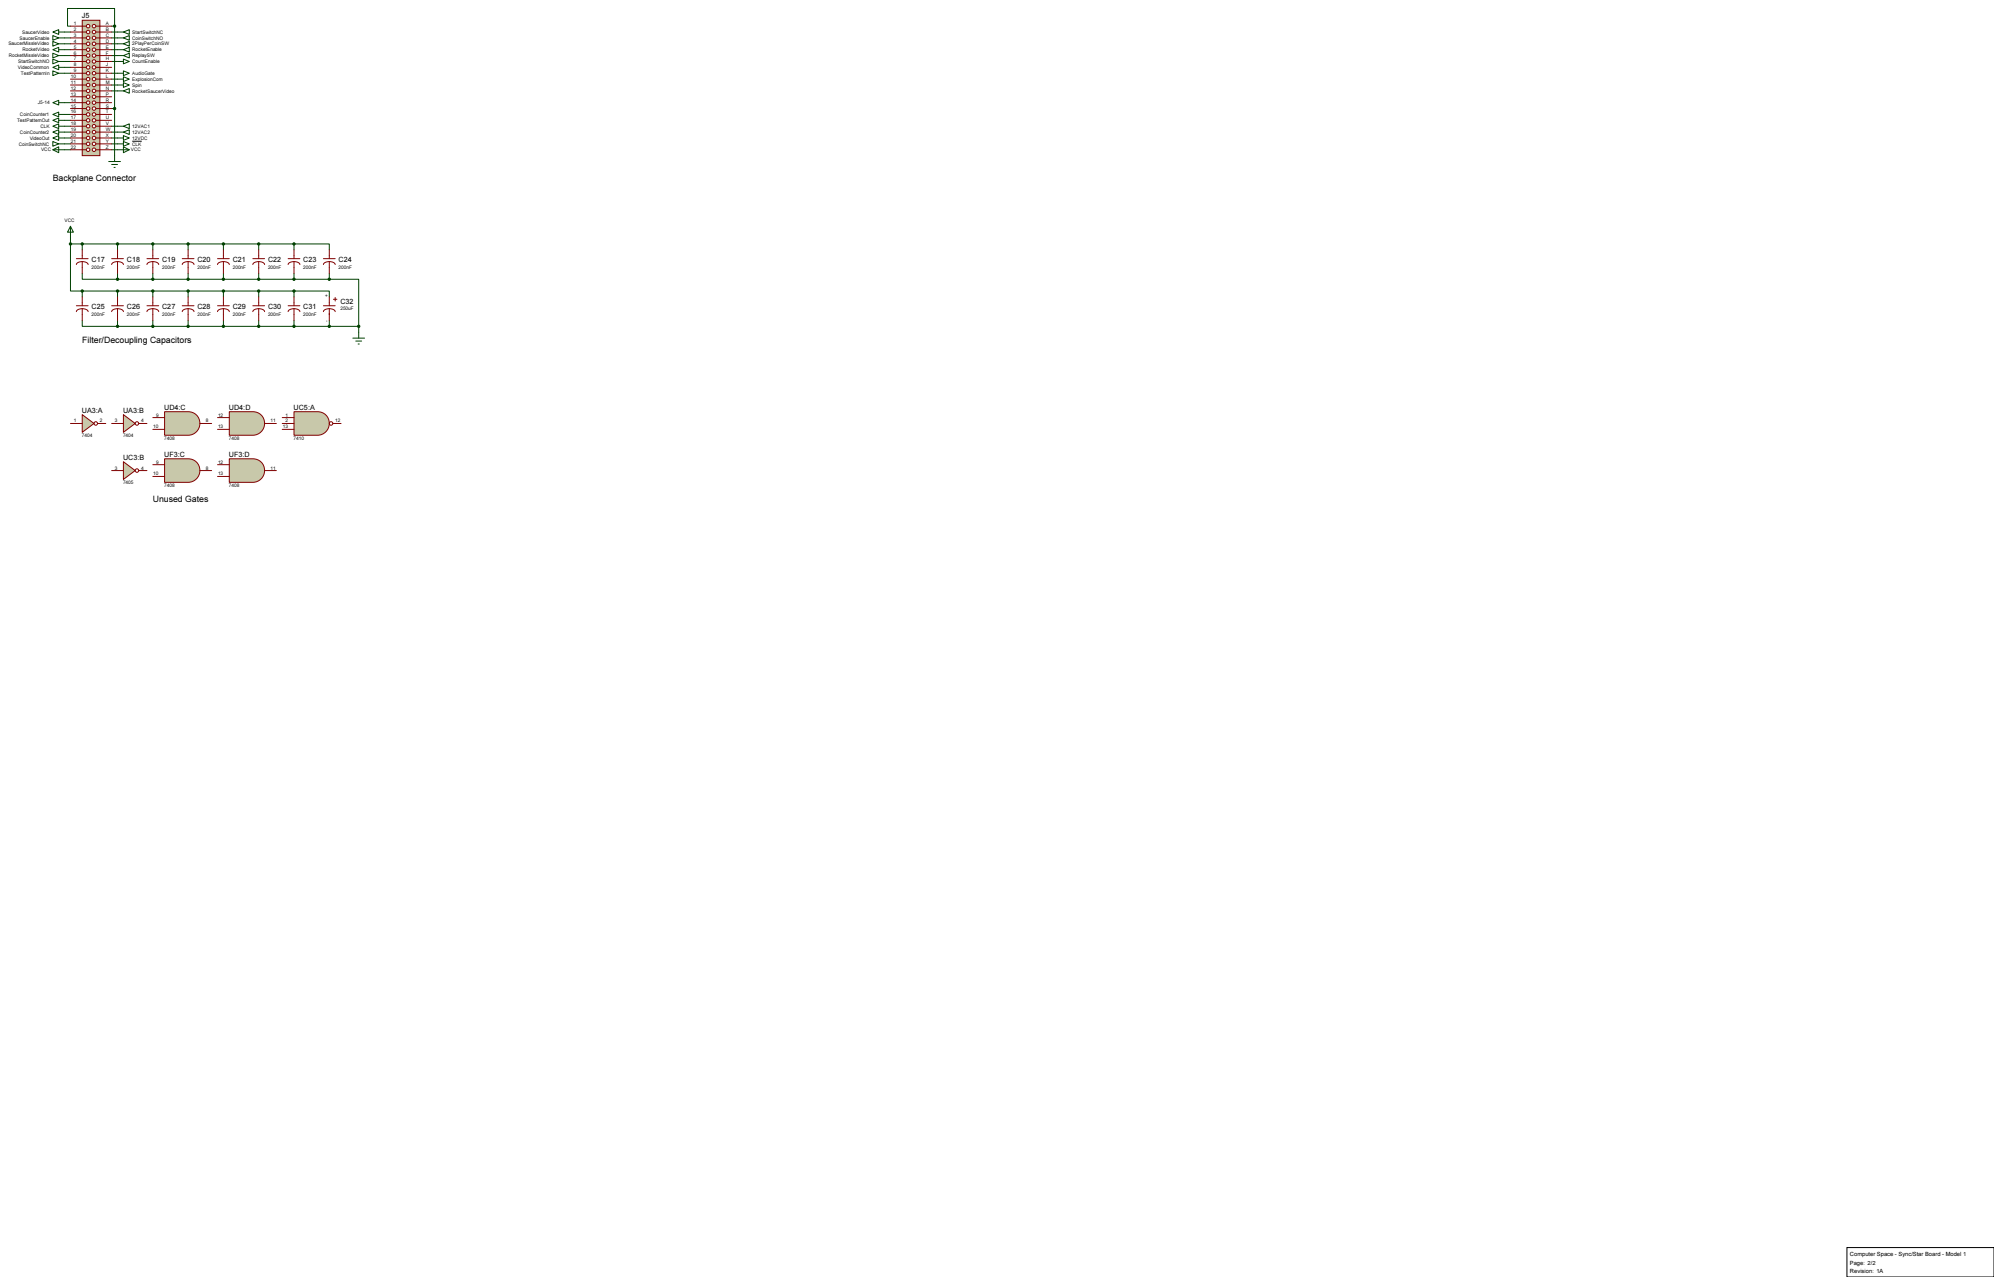
[picture p20: page 2]

Computer Space - Sync/Star Board - Model 1
Page:
Revision:
