pong74ls/ComputerSpaceDesign/PDF/Computer Space - Sync Star Board Model 2 - Schematic.pdf

R4

R3

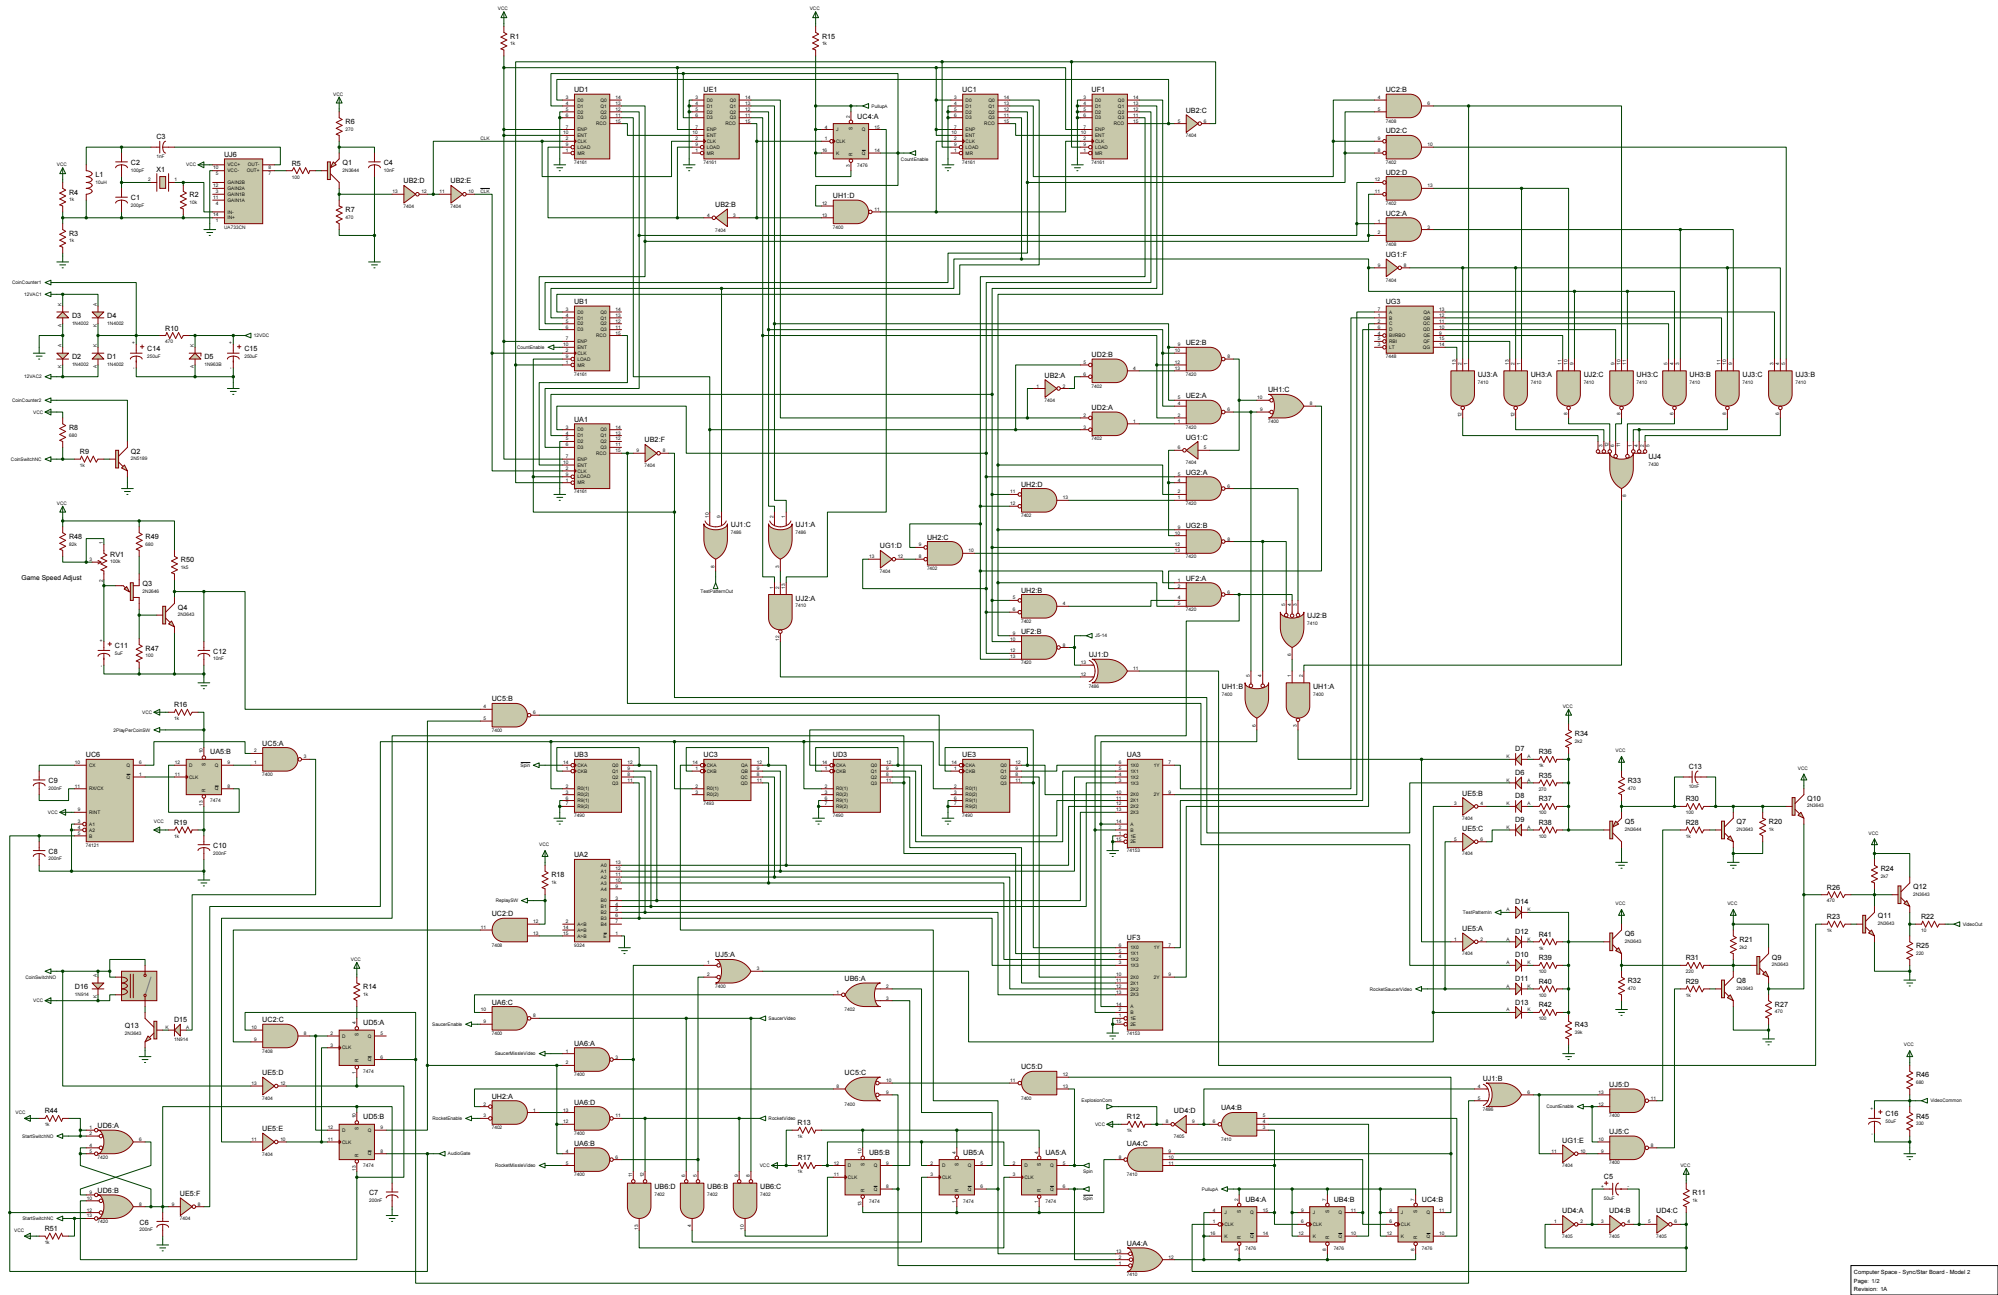
[picture p21: page 1]

Computer Space - Sync/Star Board - Model 2
Page:
Revision:

J5

C19

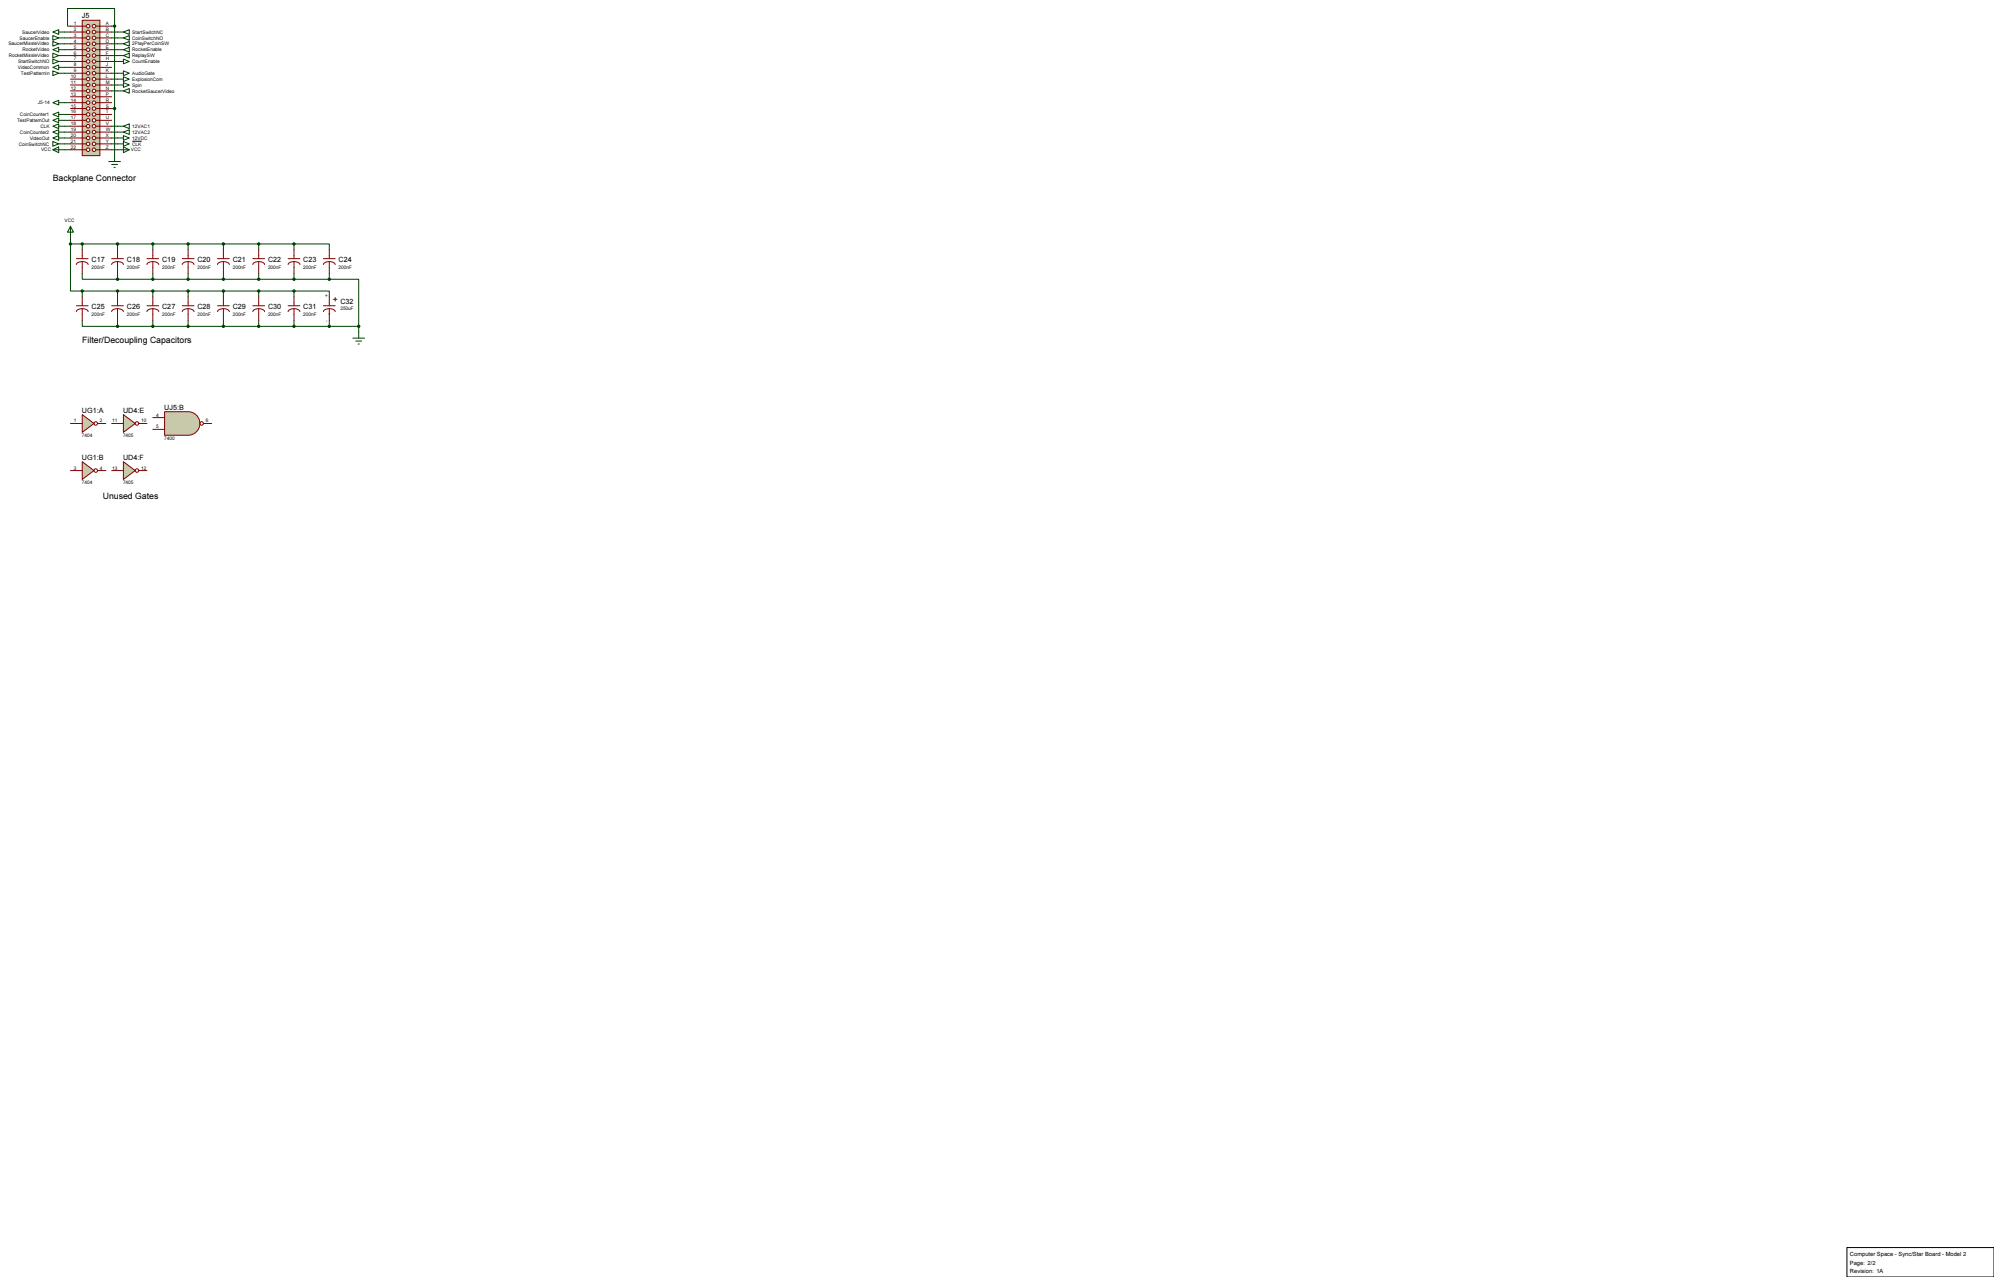
[picture p22: page 2]

Computer Space - Sync/Star Board - Model 2
Page:
Revision:
