pong74ls/ComputerSpaceDesign/PDF/Computer Space - Memory Board - PCB Layout.pdf

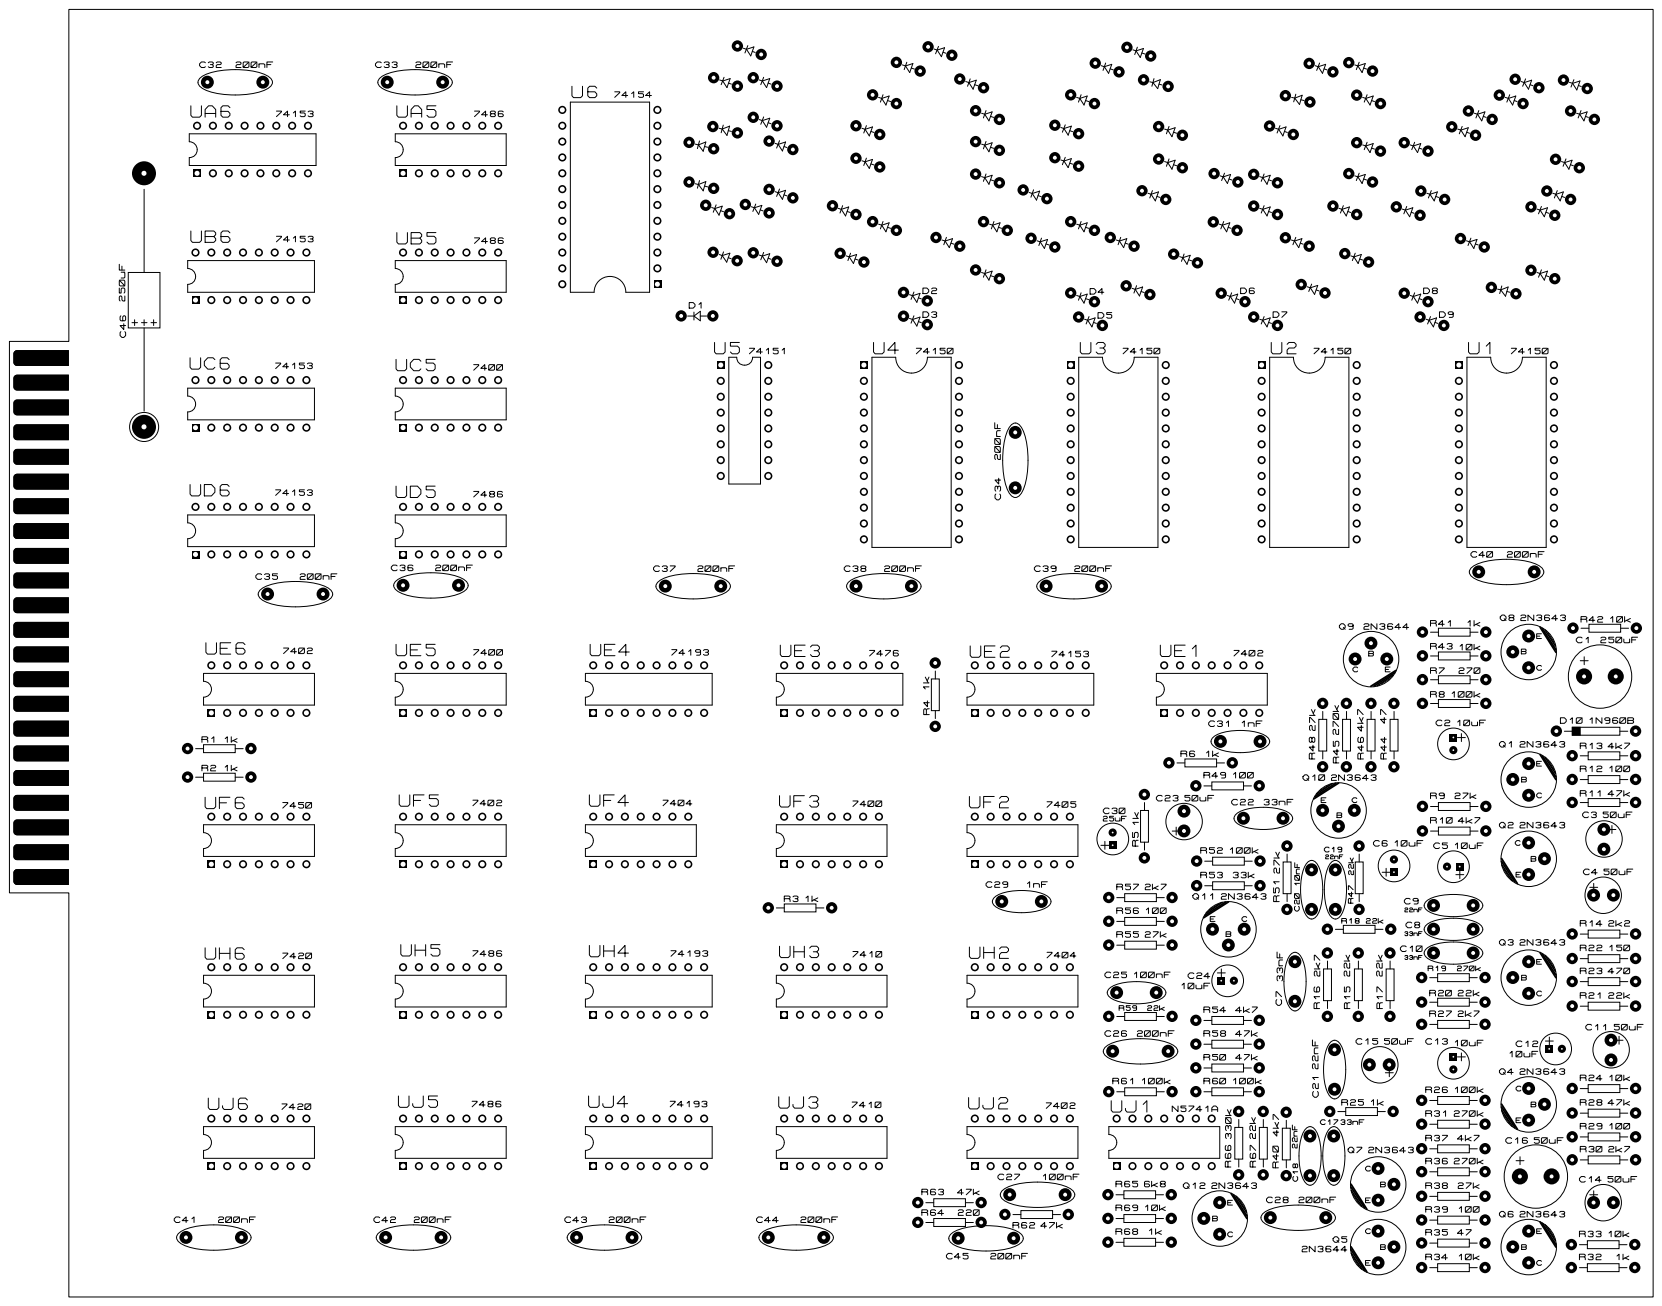
[picture p23: page 1]
