pong74ls/ComputerSpaceDesign/PDF/Computer Space - Motion Board - PCB Layout.pdf

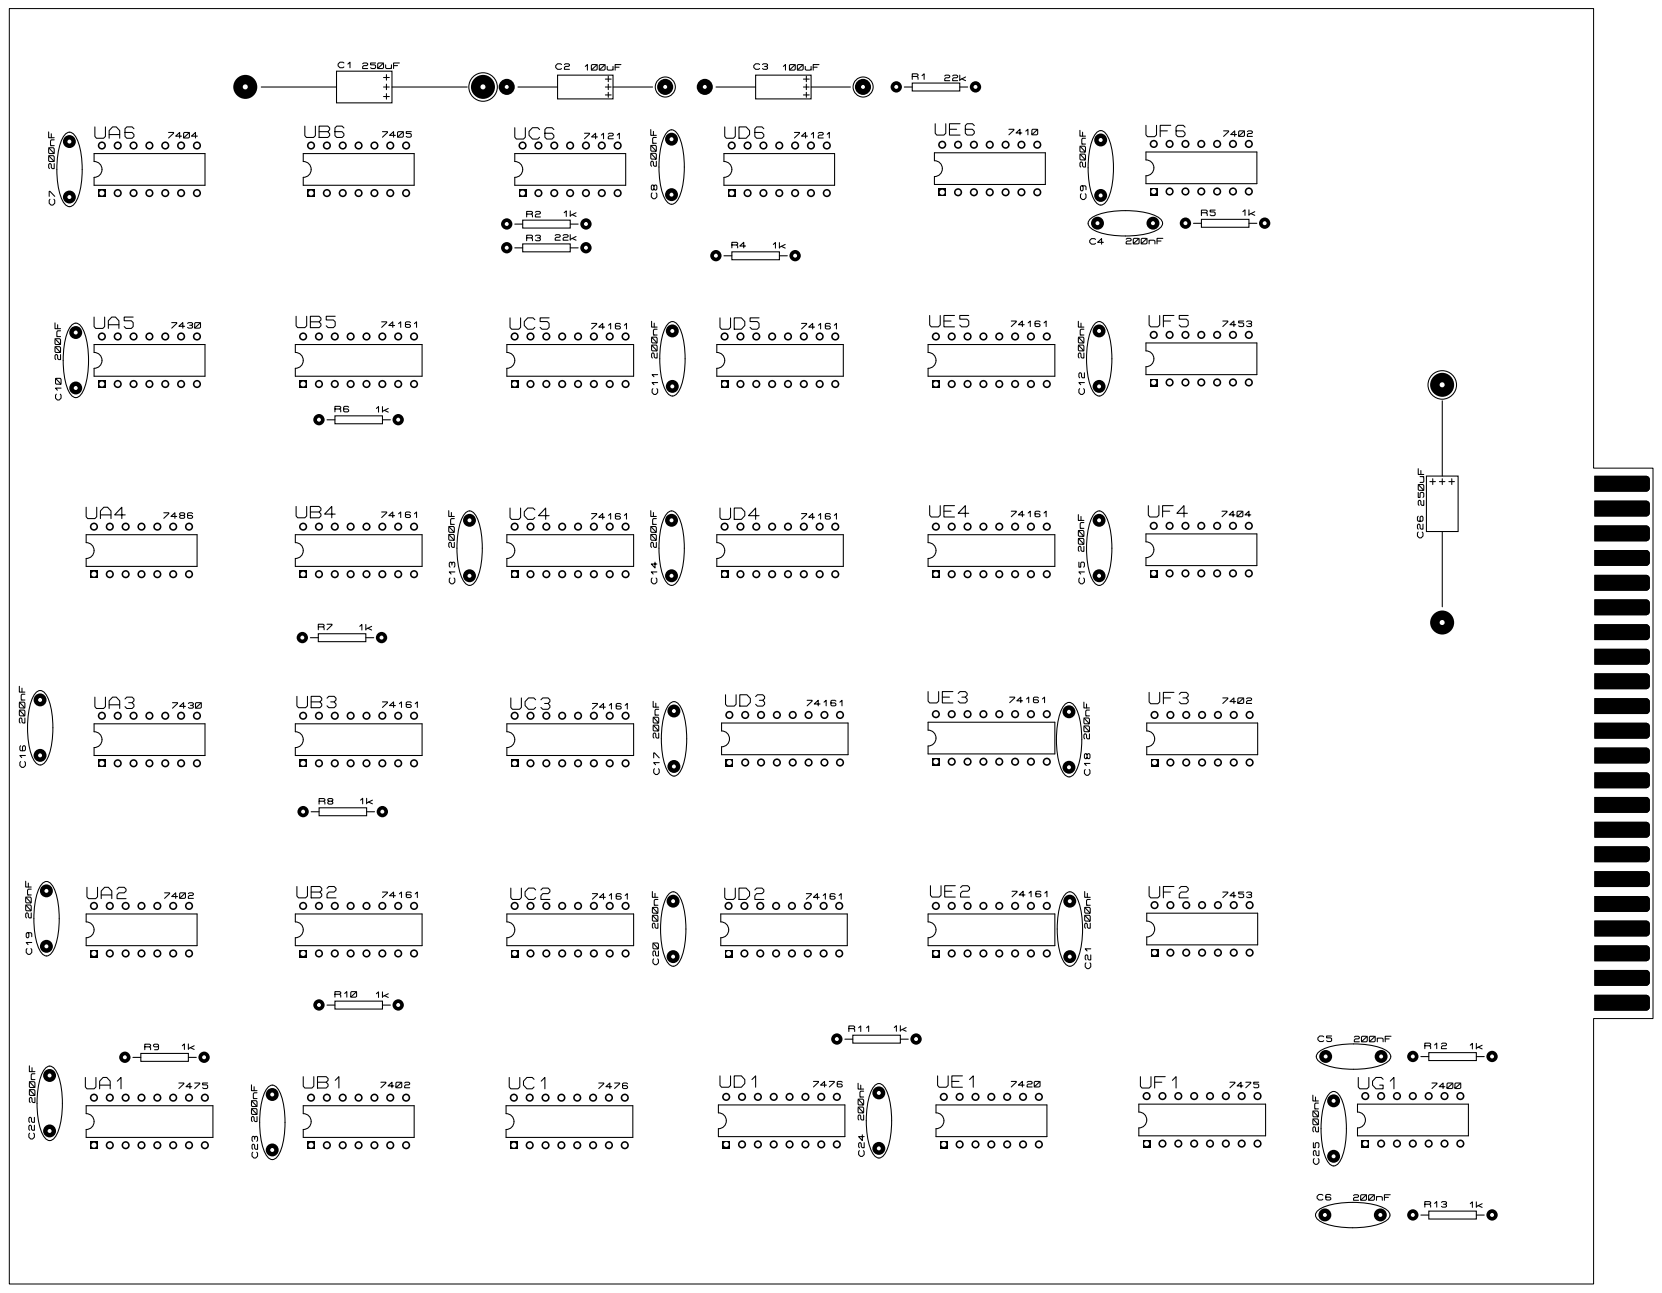
[picture p24: page 1]
