pong74ls/ComputerSpaceDesign/PDF/Computer Space - Sync Star Board Model 1 - PCB Layout.pdf

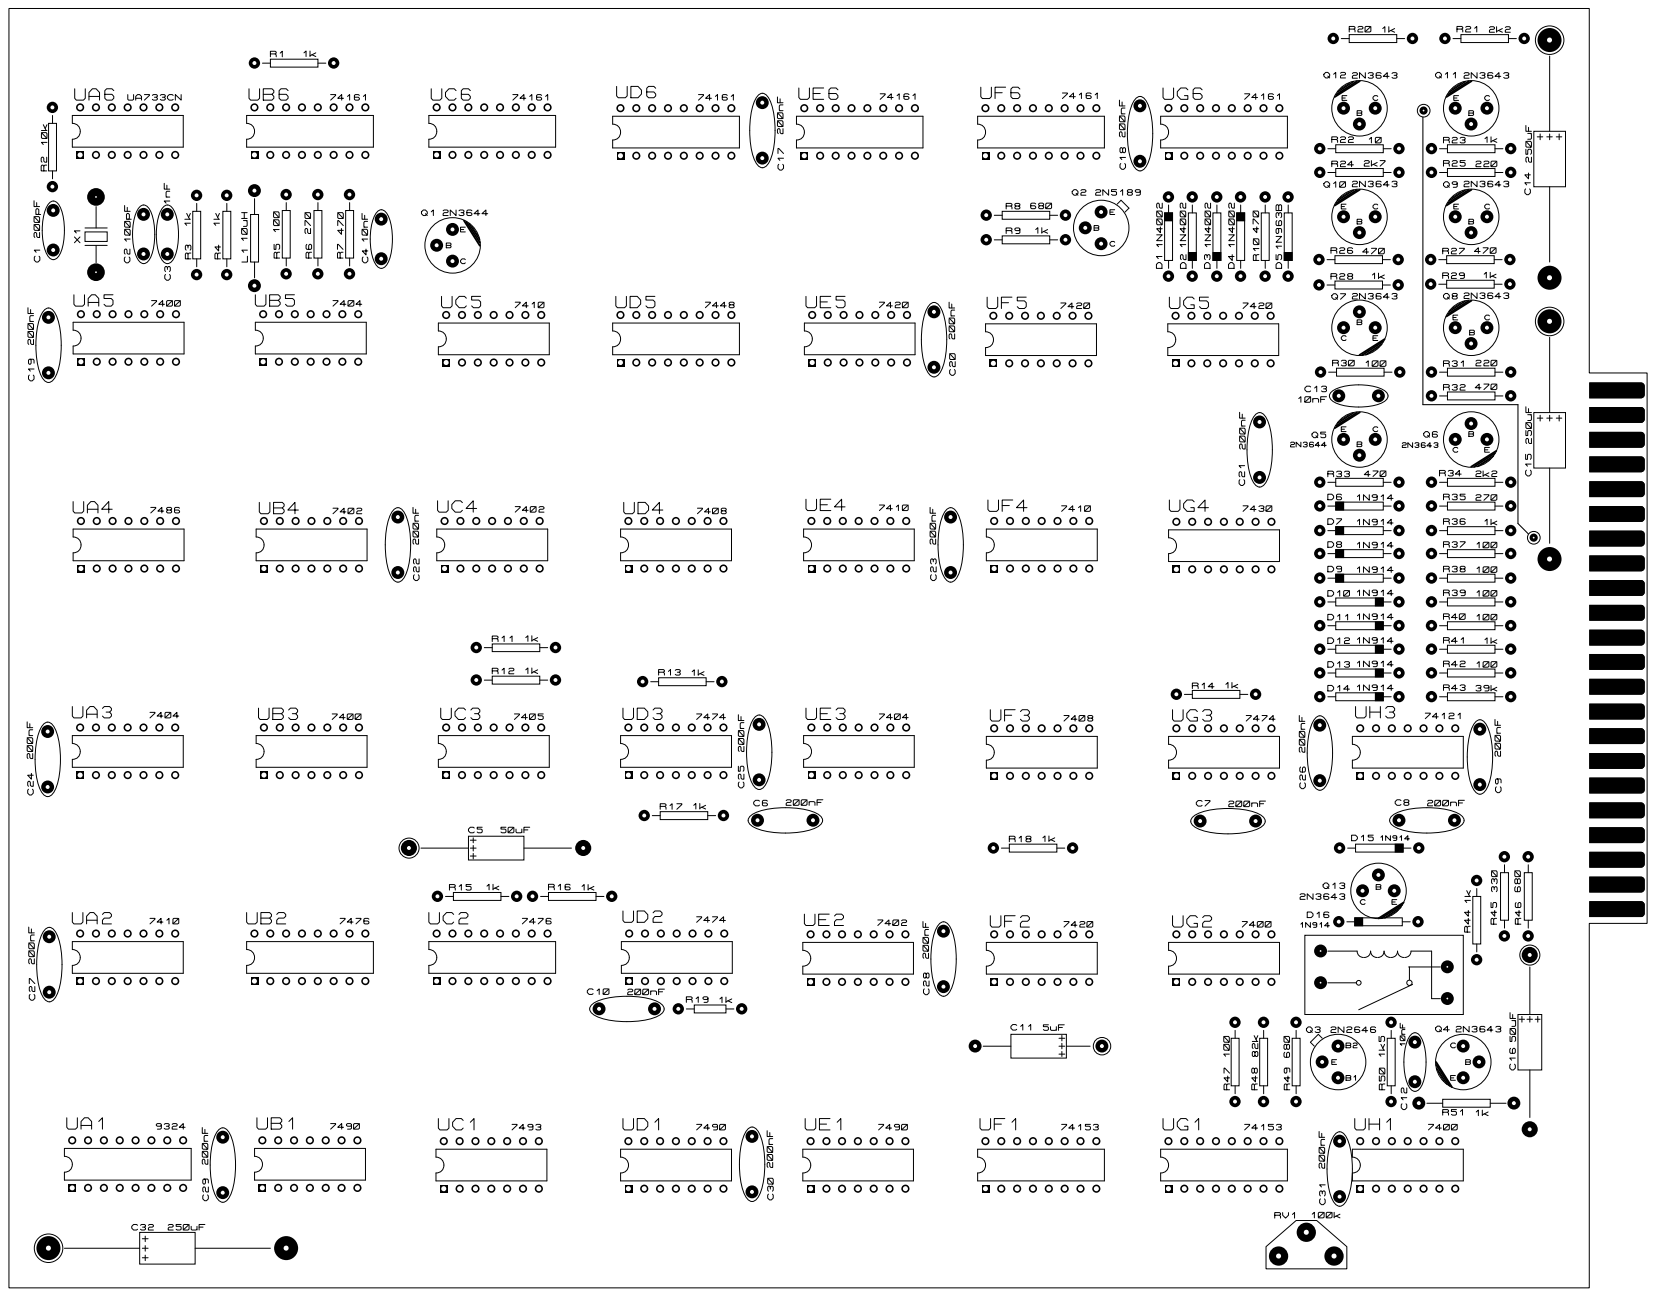
[picture p25: page 1]
