pong74ls/ComputerSpaceDesign/(list of files, drawings)

Other design files:
Computer Space - Backplane Bus.pdsprj
Computer Space - Memory Board.pdsprj
Computer Space - Motion Board.pdsprj
Computer Space - Sync Star Board Model 1.pdsprj
Computer Space - Sync Star Board Model 2 - Old.pdsprj
Computer Space - Sync Star Board Model 2.pdsprj
