pong74ls/ComputerSpaceDesign/PCB Pictures/Memory Board - Solder Side.JPG

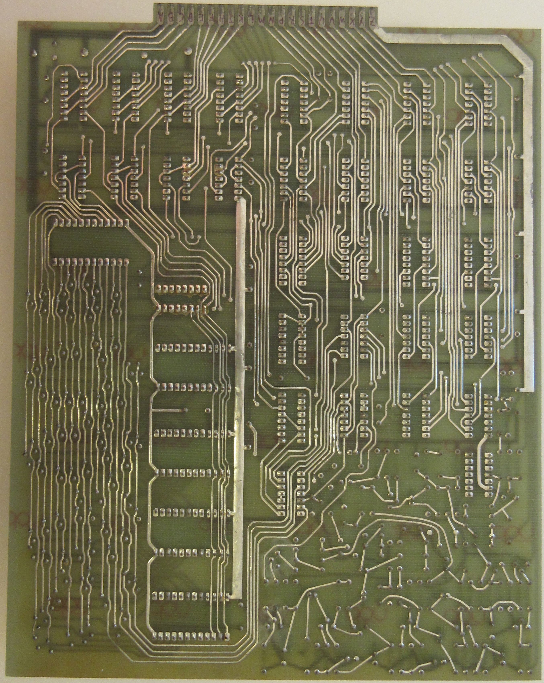
PCB Pictures/Memory Board - Solder Side.JPG
